mohan4220/ecu/docs/circuits/README.md

# ECU-25 Reference Circuits

Generated by `hardware/reference-circuits/generate.py` (schemdraw). These are the
design references — component values calculated below — and the source of truth
until the KiCad schematics are captured. Each SVG/PNG pair shows one channel;
multiply by channel count for the full board.

For the channel-by-channel signal list — every quantity measured, its terminal,
scaling and MCU pin, and every output driven — see
[docs/io-map.md](../io-map.md).

| # | Circuit | Channels on board |
|---|---|---|
| 00a | System context block diagram | — |
| 00b | Main-board subsystem block diagram | — |
| 01 | Power input protection | 1 |
| 02 | Buck 12 V → 5 V | 1 |
| 02b | COT ripple injection (Type-3) | 1 |
| 03 | LDO 5 V → 3.3 V | 1 |
| 04 | Digital input | 8 |
| 05 | Resistive sender input | 3 |
| 06 | MPU / RPM input | 1 |
| 07 | AC voltage sense | 6 |
| 08 | CT input | 3 |
| 09 | Relay driver | 6 |
| 10 | CAN transceiver | 1 |
| 11 | RS485 transceiver | 1 |
| 12 | MCU core (crystals, reset, boot, SWD, RTC backup) | 1 |
| 13 | VREF_MID 1.65 V buffer | 1 (feeds 9 ch) |
| 14 | Switched 12 V rail (+12V_SW) | 1 |
| 15 | Battery voltage sense | 1 |
| 16 | Charge alternator D+ excite/sense | 1 |
| 17 | EEPROM SPI wiring | 1 |
| 18 | Display board — 4.3" TFT + RA8875 (block level) | 1 board |

Ordering: [../bom/ecu25-main-bom.md](../bom/ecu25-main-bom.md) (generated from
the schematic). Bench work: [../bom/breadboard-prototype.md](../bom/breadboard-prototype.md)
— through-hole substitutes per subsystem, with a build order and the safety
rules for the AC-sensing and CT blocks.

## Design calculations

### 01 — Input protection
- **System: 12 V, ~75 Ah battery** (Kirloskar KG4-25WS1 / engine 3R550ETA 4G1, CPCB IV+ — the whole 25-58.5 kVA range is 12 V). Board spec 8-16 V.
- F1 **3 A**: real board draw is ≈0.45 A (buck ~0.13 A, coils 0.20 A, D+ 0.10 A, DIN wetting 13 mA, or up to 96 mA if all eight channels are jumpered ground-side with contacts closed). A 5 A blade is 11× the load and could not clear a 1 A internal fault; 3 A tightens coverage while still clearing the C9 inrush (I²t ≈ 0.8 A²s against a ~3.5 A²s melt).
- D1 SMCJ16CA: 16 V standoff (above the 15 V charging max), clamps ≈26 V; buck is 100 V rated → large margin.
- **Jump-starting from a 24 V source will destroy this board, by design.** ISO 16750-2 specifies a 24 V / 60 s jump-start test for 12 V systems; with a 16 V-standoff TVS we clamp, blow F1, and D1 most likely fails short — the safe direction, but a sacrificial one. This is the price of clamping at 26 V instead of 53 V, which is what protects the LM358s (32 V absolute max) sitting on the raw rail. If 24 V jump-start survival is ever required the answer is a series-pass overvoltage cutoff, not a bigger TVS. **The installation manual must say: do not jump-start from 24 V.**
- Q1 P-FET −60 V: survives clamped load dump. R1 100k gate pull-down; D2 12 V zener holds V_GS within the FET rating.
- C1 100 µF 35 V + C2 100 nF sit on the battery side of D3 and handle ripple, not ride-through.
- **Crank ride-through (D3 + C9).** A 12 V system dips far lower under crank than a 24 V one, so the logic gets its own diode-isolated reservoir: D3 (SS34) blocks, C9 2200 µF holds. With the backlight shed, the logic draws ≈1 W at the buck input; from 10 V down to the 6.5 V UVLO that is ½·C·(10²−6.5²) = 0.05 J ≈ 1.7 mF minimum, so 2200 µF carries ≈63 ms — against the DSE-class figure of surviving 0 V for 50 ms from ≥10 V. **That 1 W is a ceiling, not a margin**: it assumes the backlight is shed, and at 1.5 W the hold-up falls to ~42 ms and the claim fails. Two consequences to close on the first board: measure the real load and re-derive, and *implement* the backlight shed (battery sense taps +12V ahead of D3, so the sag is visible within one 10 ms tick) — today it is an assumption, not code. Inrush into C9 is ~58 A for ~0.5 ms, which the SS34 (100 A I_FSM) and the fuse both survive, but it pits screw terminals on repeated hot-plugging. The coils tap +12V *ahead* of D3 and simply latch through the sag; a G5LE releases far below 12 V.
- **The UVLO divider senses the hold-up node, not the battery.** Sensing the battery would trip EN the instant the harness sagged and shut the buck off while C9 still held charge — defeating the whole reservoir.

### 02 — Buck (LM5164-Q1)
- FB ref 1.2 V: R5/R6 = 38.3k/12.1k → V_OUT = 1.2 × (1 + 38.3/12.1) = 5.00 V.
- UVLO: EN threshold 1.5 V rising / 1.4 V falling, R2/R3 = 100k/30.1k → turn-on **6.48 V**, turn-off **6.05 V** (0.43 V hysteresis). Turn-off sits essentially on the LM5164's own 6 V minimum input, which is deliberate — the datasheet supports operation down to 6 V at near-100 % duty — but it means a battery parked between 6.05 and 6.48 V during a very long crank will chatter.
- RON = **41.2k** → fsw = V_OUT × 2500 / R_RON = 5 × 2500 / 41.2 ≈ **303 kHz**. The formula has **no V_IN term**: the LM5164 varies on-time inversely with V_IN precisely so frequency stays constant, so an earlier claim here that frequency scaled with input volts was wrong — and the old 100k was never 300 kHz at *any* input, it was 125 kHz. ΔI = 5 × 0.583 / (303 kHz × 33 µH) ≈ 0.29 A (29 %), rising to ≈0.33 A at 14.4 V — well inside the LM5164's 1.5 A peak limit.
- **Type-3 ripple injection (R7 100k, C10 4.7 nF, C11 1 nF C0G).** COT has no error amplifier: the on-time restarts when FB falls to the 1.2 V reference, so the datasheet requires ≥20 mV of FB ripple *in phase* with the inductor current. Our all-ceramic output produces ΔI/(8·f·C) = **2.7 mV**, and that component is capacitive — out of phase — so the required series resistance would be R_ESR ≥ V_OUT×20 mV/(V_FB×ΔI) = **0.287 Ω** against the ~2 mΩ two 22 µF MLCCs actually have, i.e. two orders of magnitude short. Left alone the part burst-switches (multiple on-times then a long off-time). Type-3 avoids adding output ESR: R7/C10 across SW and V_OUT rebuild the triangular ramp, C11 couples it into FB. C10 ≥ 10/(f_SW·(R5∥R6)) = 10/(303 k × 9.20 k) = 3.6 nF → 4.7 nF; R7 ≤ t_ON·(V_IN−V_OUT)/(20 mV·C10) = 1.31 µs × 7.6 / (20 m × 4.7 n) = 106 k → **100 k**, giving 21 mV at 12.6 V and 13 mV at 8 V (datasheet floor 12 mV). At the 6.5 V UVLO edge it falls to ~8 mV — below spec, but that is a sub-second crank transient, not an operating point. C11 ≥ t_settle/(3·R5) = 75 µs/115 k = 0.65 nF → **1 nF, C0G** (a Y5V here would lose most of its value under bias). Cost of the network: the injected ramp shows up as a DC error of about half its amplitude, ~10 mV at FB, ~44 mV at the output.

### 03 — LDO (TLV75533)
- Fixed 3.3 V, 500 mA (reviewer: TPS7A4901's 150 mA was marginal — MCU ~100 mA + RS485 ~25 mA + display logic ~40 mA + peaks).
- LCD backlight runs from the 5 V rail over the ribbon, not from the LDO.

### 04 — Digital input
- Divider **5.6k/1.8k** from 12 V → 2.92 V at node, wetting current ≈ 1.6 mA. The old 10k/3.3k gave 5.95 V and 1.8 mA at 24 V but only **0.9 mA** at 12 V — below what reliably breaks through oxide on a dirty panel contact.
- R12 + BAT54S clamps node to rails; clamp current ≈ 0.24 mA worst case.
- τ = (5.6k∥1.8k) × 1 µF ≈ 1.4 ms; firmware debounce ×3 samples on top.
- Ground-switched contacts: R231-238 (**1k** to +12V, via JP4-11) pull the input high so a contact to GND reads as active. Fit either the pull-up or the field 12 V feed, never both. The value is set by the *worst* case, not the nominal one: the open-contact node is V_bat × 1.8/(R+7.4), and against V_IH 1.785 V that needs R ≤ 670 Ω at 8.0 V — 2.2k gives 2.25 V at 12.6 V but only **1.59 V at the 8.5 V crank sag**, back inside the indeterminate band (SME catch). 1k gives 2.57 V at 12.6 V and 1.82 V at 8.5 V. Cost: 12 mA per channel while the contact is closed, against 5.5 mA at 2.2k.

### 05 — Sender input
- Current source (LM358 + BC857 + R_set, drawn as I1): 0.5 V ref across 62 Ω → 8.06 mA (oil, fuel); 249 Ω → 2.0 mA (temp, avoids saturation on cold NTC).
- Implementation (KiCad): high-side source from +5 V; the 0.5 V drop is set by a 4.5 V reference (10k/90.9k + 100 nF from +5 V) on the op-amp +input, feedback from the BC857 emitter. LM358 runs from +12 V so its input common-mode range (V+ − 1.5 V) clears the 4.5 V reference easily.
- Oil 184 Ω × 8 mA = 1.48 V full scale; 12-bit ADC → ≈0.1 Ω resolution.
- R23/C20 filter; R26 4.7k + BAV199 clamp holds the fault current into the MCU pin to ≈3.6 mA when a sender shorts to +12 V.

### 06 — MPU / RPM
- C30 AC-couples; R31/R32 bias +input to 1.65 V; R33/R34 set −input threshold 1.65 V.
- R36 1M positive feedback: hysteresis ≈ 3.3 V × (50k / 1.05M) ≈ ±80 mV.
- BAV99 + R30 clamp ±50 V pickup swings.

### 07 — AC voltage sense
- 4 × 330k + 5.62k: ratio 1/235.9 → 340 Vpk → 1.44 Vpk about the 1.65 V bias (ADC sees 0.22–3.08 V). Clips at ≈276 V RMS — above the 110 % over-voltage trip point (264 V), so protection still reads real numbers at trip.
- Fault current if output shorted: 340 V / 1.32 MΩ ≈ 0.26 mA — inherently safe.
- 4 series 1206 → ≈85 Vpk per resistor (200 V rated) + creepage across the chain.
- R45/C40: effective fc ≈ 1.1 kHz (source ≈ 5.62k∥1.32M + 1k with 22 nF), −2.6° at 50 Hz. CT channel: R53 6.8k + 22 nF → fc ≈ 1.06 kHz — matched within ≈0.1°, so the phase error cancels in power/PF.
- Terminals (KiCad, J5/J6): 8-pole 5.08 mm blocks with only the **odd poles wired** → 10.16 mm live-to-live pitch. 415 V L-L rides between adjacent phases (and up to ~680 Vpk GEN-phase to MAINS-phase between unsynchronized sources); a fully-populated 400 V-class 5.08 mm block doesn't meet PD2 creepage for that (PCB review catch). On-board: 3.0 mm clearance class + copper-pour keepout under the terminals and divider chains.

### 08 — CT input
- Burden 0.05 Ω: 5 A RMS → 0.25 V RMS, dissipation 1.25 W on a 3 W part (42 % derating).
- MCP6002 ×2 → ±0.71 Vpk about 1.65 V at rated current; output clips at ≈11.7 A RMS (2.3×In) — ample for time-graded overcurrent curves. The gain pairs (R51/R52 etc.) are **1 %**: two 5 % parts would give up to 7 % gain error on every current and power reading.
- D50 bidirectional TVS across the CT terminals — protects the pluggable connector if a live CT is opened.
- R53 6.8k phase-matches the voltage-channel filter (see 07).

### 09 — Relay driver
- 2N7002K (60 V): **G5LE-1-DC12** coil is 360 Ω / 400 mW → **33.3 mA**; six coils ≈ 200 mA. 60 V clears the 26 V clamp with a wide margin. R61 keeps the FET off during MCU reset.
- SS34 flyback clamps coil kickback to ~0.4 V above +12V_SW.
- **Contacts are dry and pilot-duty.** J8 is a 6-pole body, all six wired: pins **1 and 6 are both OUT_COM**, the common contact supply, which the *installer* feeds from a fused source — it is not this board's rail, so no field current crosses the PCB. Two poles rather than one so the installer can land a supply and a jumper without doubling wires into one terminal. Pins 2-5 are the NO contacts: FUEL (ECU enable), START, AUX1, AUX2.
- **OUT_COM rating: 4 A total, 2 A per output, installer fuse 4 A.** The relay contacts are 8 A each, but the *board* is the limit: OUT_COM runs in the Battery class (2.0 mm ≈ 4-5 A at a 10-20 °C rise, IPC-2221 external 1 oz) and each output in the Power class (1.0 mm ≈ 2.4 A). Four contacts at their 8 A rating would be 32 A on a trunk sized for 4 — so the ceiling has to be stated, and it belongs on the installer's drawing (SME catch: it was implied by the netclass and written down nowhere). **START is pilot only**: a 12 V starter solenoid pulls 20-40 A and glow plugs 28-60 A against 8 A DC contacts, so it must drive an external starter relay coil.
- +12V_SW therefore feeds only the six coils (200 mA) and the D+ excitation (100 mA).
- K5/K6 are **configurable** (AUX1/AUX2, defaulting to horn and preheat): on a CRDi engine the ECU owns the cold-start aid, so a hard-wired preheat channel would often sit idle.
- GEN and MAINS contactor channels are **volt-free pairs** (COM+NO) on their own block **J15** — GEN and MAINS contactor channels are **volt-free pairs** (COM+NO) on their own block **J15** — contactor coils run on their own AC source, and the panel hardware interlock stays load-bearing. J15 is an 8-pole 5.08 mm body with only the **odd poles wired** (10.16 mm live pitch): the two contactor circuits ride different AC sources (up to ~650 Vpk between them), which a fully-populated 5.08 mm block can't hold creepage for (PCB review catch — same reason J8's old poles 5–8 moved off it).
- G5LE-1 pin map (lib symbol/footprint): coil = pins 2/5, COM = 1, NO = 3, NC = 4 unused (PCB review catch — an earlier assumption of 1/2 = coil netted every relay wrong).
- K1 run-enable energizes from PREHEAT onward (not just crank): gives a J1939 engine ECU its boot time before the starter engages; in legacy mode it merely energizes the fuel solenoid early.

### 10/11 — Comms
- CAN split termination 2 × 60 Ω + 4.7 nF (fit JP1 only at bus ends) — better common-mode filtering than single 120 Ω.
- RS485: 120 Ω term (JP2, ends only). THVD1450 has a true fail-safe receiver; the 560 Ω bias is belt-and-braces (with both terminations fitted it only reaches ≈170 mV — the internal fail-safe is what guarantees idle state).

### 12 — MCU core
- **VCAP1/2: 2 × 2.2 µF** for the F407's internal 1.2 V core regulator — mandatory, the MCU does not boot without them. VREF+ ties to the filtered VDDA.
- HSE 8 MHz, load caps 12 pF (C = 2(CL−Cstray) with CL = 10 pF, stray ≈ 4 pF); LSE 32.768 kHz, 6.8 pF (CL ≈ 6 pF low-drive).
- VBAT: BAT54 + 330 Ω charges the 0.22 F supercap gently — without the resistor the 3.3 V LDO sits in current limit for seconds at every cold start. RTC draw ~1 µA → ≈60 h backup.
- VDDA fed through ferrite + 1 µF/10 nF — keeps digital switching noise off the ADC reference.
- BOOT0 10 k pulldown = boot from flash; JP3 to 3V3 invokes ROM UART bootloader (recovery without debugger).
- SWD (KiCad): TC2030 tag-connect footprint, J11 — 6 pads, no fitted connector cost; NRST also on it.

### 13 — VREF_MID buffer
- 10k/10k from 3.3 V → 1.65 V, decoupled at the divider node by C90 100 nF; MCP6002 buffer isolates the divider from 9 channel loads. 47 Ω isolation + 10 µF, dual feedback (final values, in KiCad): R93 10k takes DC feedback from after the 47 Ω, C93 100 nF closes the loop at AC directly from the op-amp output — the R92·C91 pole sits outside the fast loop, so low output impedance at 50 Hz without oscillation and no bias crosstalk between channels.

### 14 — +12V_SW
- PTC 1.1 A hold: 6 coils × 33.3 mA = 200 mA + D+ 100 mA ≈ 300 mA. Field loads are no longer on this rail (they come from J8 pin 1), so the budget covers only the coils and D+. PTC trips on a stuck/shorted coil without killing the logic supply. **RXEF110, radial, 72 V** — while tripped it stands off the ~53 V load-dump clamp, and no *chip* PPTC does that at 1.1 A hold: the 1206 0ZCJ0110 is 8 V and the 1812 parts are 33 V (BOM review catch — an earlier revision of this sheet claimed a 60 V 1812 part that does not exist). Local SMBJ33**CA** (bidirectional, matching the two-anode TVS symbol) clamps coil-switching transients — the unidirectional SMBJ33A would risk a footprint-time cathode-to-GND forward short (schematic review catch).

### 15 — Battery sense
- 100k/22k = ÷5.55 → 16 V reads 2.88 V, using most of the ADC span on a 12 V system. 12-bit LSB ≈ 4.5 mV of battery. (÷15.7 was sized for 24 V and would have used under a third of the range here.)

### 16 — Charge alternator D+
- 120 Ω 3 W from +12V_SW ≈ 100 mA excitation (replaces the charge-lamp current that self-excites the alternator). 3 W part: 1.2 W dissipates continuously during a charge-fail — exactly the fault it must survive. 220 Ω would give only 55 mA at 12 V, which may not self-excite.
- 100 nF at the ADC node, matching the battery-sense channel.
- Same ÷5.55 divider; engine running + D+ < ~half battery ⇒ charge-fail warning.

### 17 — EEPROM
- All SPI2; CS pulled up so the chip stays deselected during MCU reset; WP/HOLD tied high via 10 k (software write protection only).

### 18 — Display board
- 4.3" 480×272 color TFT via RA8875 graphics controller (own framebuffer + drawing hardware) → MCU stays on SPI, no parallel RGB bus, no MCU upgrade.
- Single SPI bus shared by RA8875, 74HC595 (LEDs), 74HC165 (keys) with separate selects → 20-way ribbon carries everything including power (3V3 logic, 5 V backlight ~250 mA, PWM dimming).
- UI firmware: LVGL, developed against its PC simulator first.

## Review status

Independently design-reviewed 2026-08-11 (all calculations re-derived, all diagrams inspected). Fixes applied: TVS polarity (14), VCAP caps (12), GND-side switch pull-up (04), comparator supply (06), V/I filter phase matching (07/08), CT burden/headroom/TVS (08), 60 V relay FET (09), supercap inrush resistor (12), 500 mA LDO (03), VREF buffer feedback (13). Notes: BAV199 symbols show one diode of the dual pair (second half to GND implied); D1 (SMCJ33CA at the time of that review, SMCJ16CA since the 12 V conversion) is bidirectional despite the unidirectional symbol; refdes get final rationalization in KiCad.

KiCad capture independently SME-reviewed 2026-08-16 (netlist re-derived against this sheet, probes run): 3 criticals + 6 majors found and fixed — buck RON short, comparator input merge, supercap diode reversed, UVLO divider defeated, RS485 bias polarity, floating spare op-amp, LED reversed, VREF dual feedback captured (R93/C93), D80 → SMBJ33CA. Re-verified against a fresh netlist: ship. The schematic (`hardware/kicad/ecu25-main/`) carries the final refdes; this sheet keeps the design math.

J1939 firmware module reviewed the same way (probe programs, J1939-71/-73/-81 conformance) — see firmware commit history for the fix list.

BOM and breadboard-prototype guide independently SME-reviewed 2026-08-25 (netlist reconciliation, datasheet checks on every part number, arithmetic re-derived). Reached back into the design: **F2 was specified as a 60 V 1812 PPTC that does not exist** (the 0ZCJ0110 is 8 V / 1206) → RXEF110 radial 72 V; C1/C2 raised to 63 V / 100 V for the same load-dump clamp; CT gain pairs and the phase-match resistors now carry explicit 1 %. Board-side: netclass clearances retuned (the LQFP-100's own pads are 0.2 mm apart, so logic rails cannot take a wide clearance class) and the GND pour now fills at the widest non-HV class. The prototype guide itself gained the G5LE-1 pin map, the R18/R26 fault-limiting resistors, split comparator supplies, a corrected relay-driver transistor, CT burden wiring rules and the grounding rules for the low-voltage AC stand-in.

A verification pass on those fixes caught three more, all now corrected: the replacement PPTC footprint was too small for an RXEF110 (0.6 mm drill against 0.81 mm leads) → `Fuse_Bourns_MF-RG900`; the BC337-40 recommended for the breadboard relay driver is **E-B-C**, the opposite of the BC557B in the sender block, and was undocumented; and the **G5LE-1 coil current was wrong by 4× in three documents** — the DC24 coil is 1.44 kΩ / 400 mW / 16.7 mA, not 360 Ω / 67 mA. Nothing downstream breaks, because every sizing decision (FET rating, PTC hold, track width, base drive) was made against the larger number and therefore keeps margin. Board-side, the GND pour now has keepouts around every NPTH barrel and the minimum through-drill is 0.2 mm to match U1's library thermal vias — with those, the generated board reports **zero DRC errors** (only the unrouted ratsnest, silk-overlap warnings and headless library artifacts remain).

12 V conversion (2026-08-25): the target set was confirmed as a **Kirloskar KG4-25WS1**, engine **3R550ETA 4G1**, CPCB IV+ — a 3-cylinder 1.65 L CRDi with **EGR + DOC** and a **12 V / 75 Ah** electrical system. The board had been designed 24 V throughout. Everything voltage-dependent was rescaled (see the sections above); the output stage was restructured so no field current crosses the PCB; K5/K6 became configurable AUX channels. Two consequences worth recording: the "360 Ω" relay coil that an earlier revision of this sheet carried was in fact the **12 V** part all along (G5LE-1-DC12 is 360 Ω / 33.3 mA), so the "correction" to 1.44 kΩ made during the BOM review was itself wrong for this system; and because the aftertreatment is EGR + DOC rather than SCR, the controller needs **no DEF/AdBlue monitoring and no DPF regeneration management** — a DOC is passive.

Firmware SME review of the AC/sensor/runtime/STM32 work (2026-09-07). Two criticals, both of which needed two modules read together to see. **A routine Modbus poll could start the engine**: `plat_rs485_tx()` busy-waited 26.6 ms for a 51-byte reply, the main loop is the only thing draining the ADC ring, and the ring held 2.5 ms — so a SCADA master reading all 23 input registers at 10 Hz punched a hole in the AC sample stream every window. `ac_sense` indexes zero crossings by sample number, so a hole reads as time that did not pass: mains frequency pinned at 53.3 Hz, outside the AMF window, and after the 5 s qualification the controller declares a mains failure and transfers load. Fixed three ways — interrupt-driven TX, a 64-set (20 ms) ring, and an overrun flag that makes the runtime discard the corrupted window rather than publish a confident wrong number. Second critical: **a shorted coolant sender silently deleted the over-temperature shutdown**. On an NTC a short and a boiling engine are the same direction; the curve called the short "invalid", `protection.c` skips the analog branch when coolant is invalid, and coolant was not in `sensors_lost` — so no shutdown and no alarm. Which end of a sender curve is a *fault* is now stated per curve rather than inferred, and an invalid coolant reading raises SENSOR_LOSS. Majors: CAN had `ABOM` clear, so the unacknowledged address claim at power-up (the engine ECU is asleep with K1 open) drove the controller bus-off in ~16 ms, permanently; Modbus register 19 clamped reverse power to zero through `sat_u16`; a single write to the mode register locked the front-panel switch out for the whole power cycle and a remote start never expired; missed control ticks were dropped silently, so a slow loop would have made crank time, cooldown and every alarm delay run slow by the same ratio; and the CT ratio was hardcoded 50:5 in firmware against 200:5 on the schematic — a 4x current error that put the overcurrent trip at 4.6x the set's rating. The ratio now lives in one constant, `ECU25_CT_PRIMARY_A`, and the schematic text matches it. Minors fixed: `PWR->CR` written before the PWR clock was enabled, a silent fallback to the 16 MHz HSI on a dead crystal (now a deliberate hang), no input filter on the pickup capture, no `ENTRY()` in the linker script, and power counted from phases whose current was below the dead band, which pushed PF above 1. Sixteen new regression tests, each mutation-checked — the previous suite passed with the interpolation removed, the J1939 merge reverted, a DIN channel misassigned and the run-hour constant wrong by 10x.

Verification pass on the 12 V conversion (2026-09-06). Re-derived every fix against the TI, Omron, Nexperia and ST datasheets rather than trusting the commit; the hold-up energy math, the RON/UVLO arithmetic, the `modbus_rx` bounds, the AUX refactor and the dry-contact stage all held. Eleven majors did not, and are now fixed: the **COT ripple-injection network was missing entirely** — an all-ceramic output gives 2.7 mV of *capacitive* FB ripple against the 20 mV in-phase the LM5164 requires, so the part would have burst-switched (→ Type-3 R7/C10/C11, section 02); the **DIN ground-side pull-up at 2.2 k fell back into the indeterminate band at 1.59 V during an 8.5 V crank sag** (→ 1 k); the C9 25 V → 35 V change never reached the orderable BOM; the netclass assertion was **blind to the suffix patterns it was written to protect** and only fired after the board had already been written (→ result-based rules, checked before any file is saved); the hold-up node was still the autogenerated `Net-(D3-K)`, so the netclass keyed off a refdes (→ named `+12V_HLD`); the battery-threshold regression test passed with `batt_high_v` mutated back to the 24 V-era 30 V, and with `batt_low_v` at 13.5 V (→ phases at 12.0, 15.0 and 16.0 V, both mutations now caught); the explainer described an SMCJ33CA's 33 V standoff under the SMCJ16CA's name, directly contradicting the jump-start warning three files away; the battery-sense section still carried the ÷15.7 numbers (0–51 V, 12.6 mV/count) after the divider became ÷5.55; the circuit guide cited the generic 0.3/0.7·VDD logic thresholds four lines after citing the datasheet ones, which made its own fix look wrong; the OUT_COM **current ceiling was implied by the netclass and stated nowhere** (→ 4 A total, 2 A per output); and the reference diagrams still drew a 5 A fuse, a BZT52C15, an SQJ457EP and a buck with no D3/C9 at all. Sim-side, the plant's 0.1 V/s battery recovery kept the model below `batt_low` for 68 s across three crank attempts — a modelling artefact that would have masked real battery scenarios (→ 2 V/s below 11.5 V). Modbus now answers a too-small buffer with 0x04 SLAVE DEVICE FAILURE rather than 0x03, which had told the master to go looking for a bad field it never sent.

Footprint assignment + starting-point PCB independently SME-reviewed 2026-08-16 (pin-function mapping probes, ratings vs this sheet, IEC 60664-1 clearance/creepage): 1 critical — G5LE-1 relay pin map wrong (coil is 2/5, COM 1, NO 3; all six relays were netted dead with GEN/MAINS contacts tied to logic GND) — plus: GND had landed in the 415 V clearance class; 2.5 mm was insufficient for GEN-vs-MAINS (~680 Vpk); MKDS-3 fully-populated under-rated for 415 V L-L (→ 8-pole odd-wired J5/J6/J15, volt-free pairs split off J8 onto J15); volt-free nets unclassified; CT front-end and buck hot-loop parts packed far from their function; PTC 33 V under-rated (→ 60 V). All fixed and re-verified. Residual (accepted): 0.05 R shunt needs wide copper + Kelvin routing at layout time; DRU net names go stale if the project is re-annotated by hand (regenerate instead).

## Regenerating

```
.venv/bin/python hardware/reference-circuits/generate.py
```
