mohan4220/ecu/hardware/kicad/ecu25-main/ecu25-main.kicad_pcb

## KiCad design hardware/kicad/ecu25-main/ecu25-main.kicad_pcb (2026-09-07)

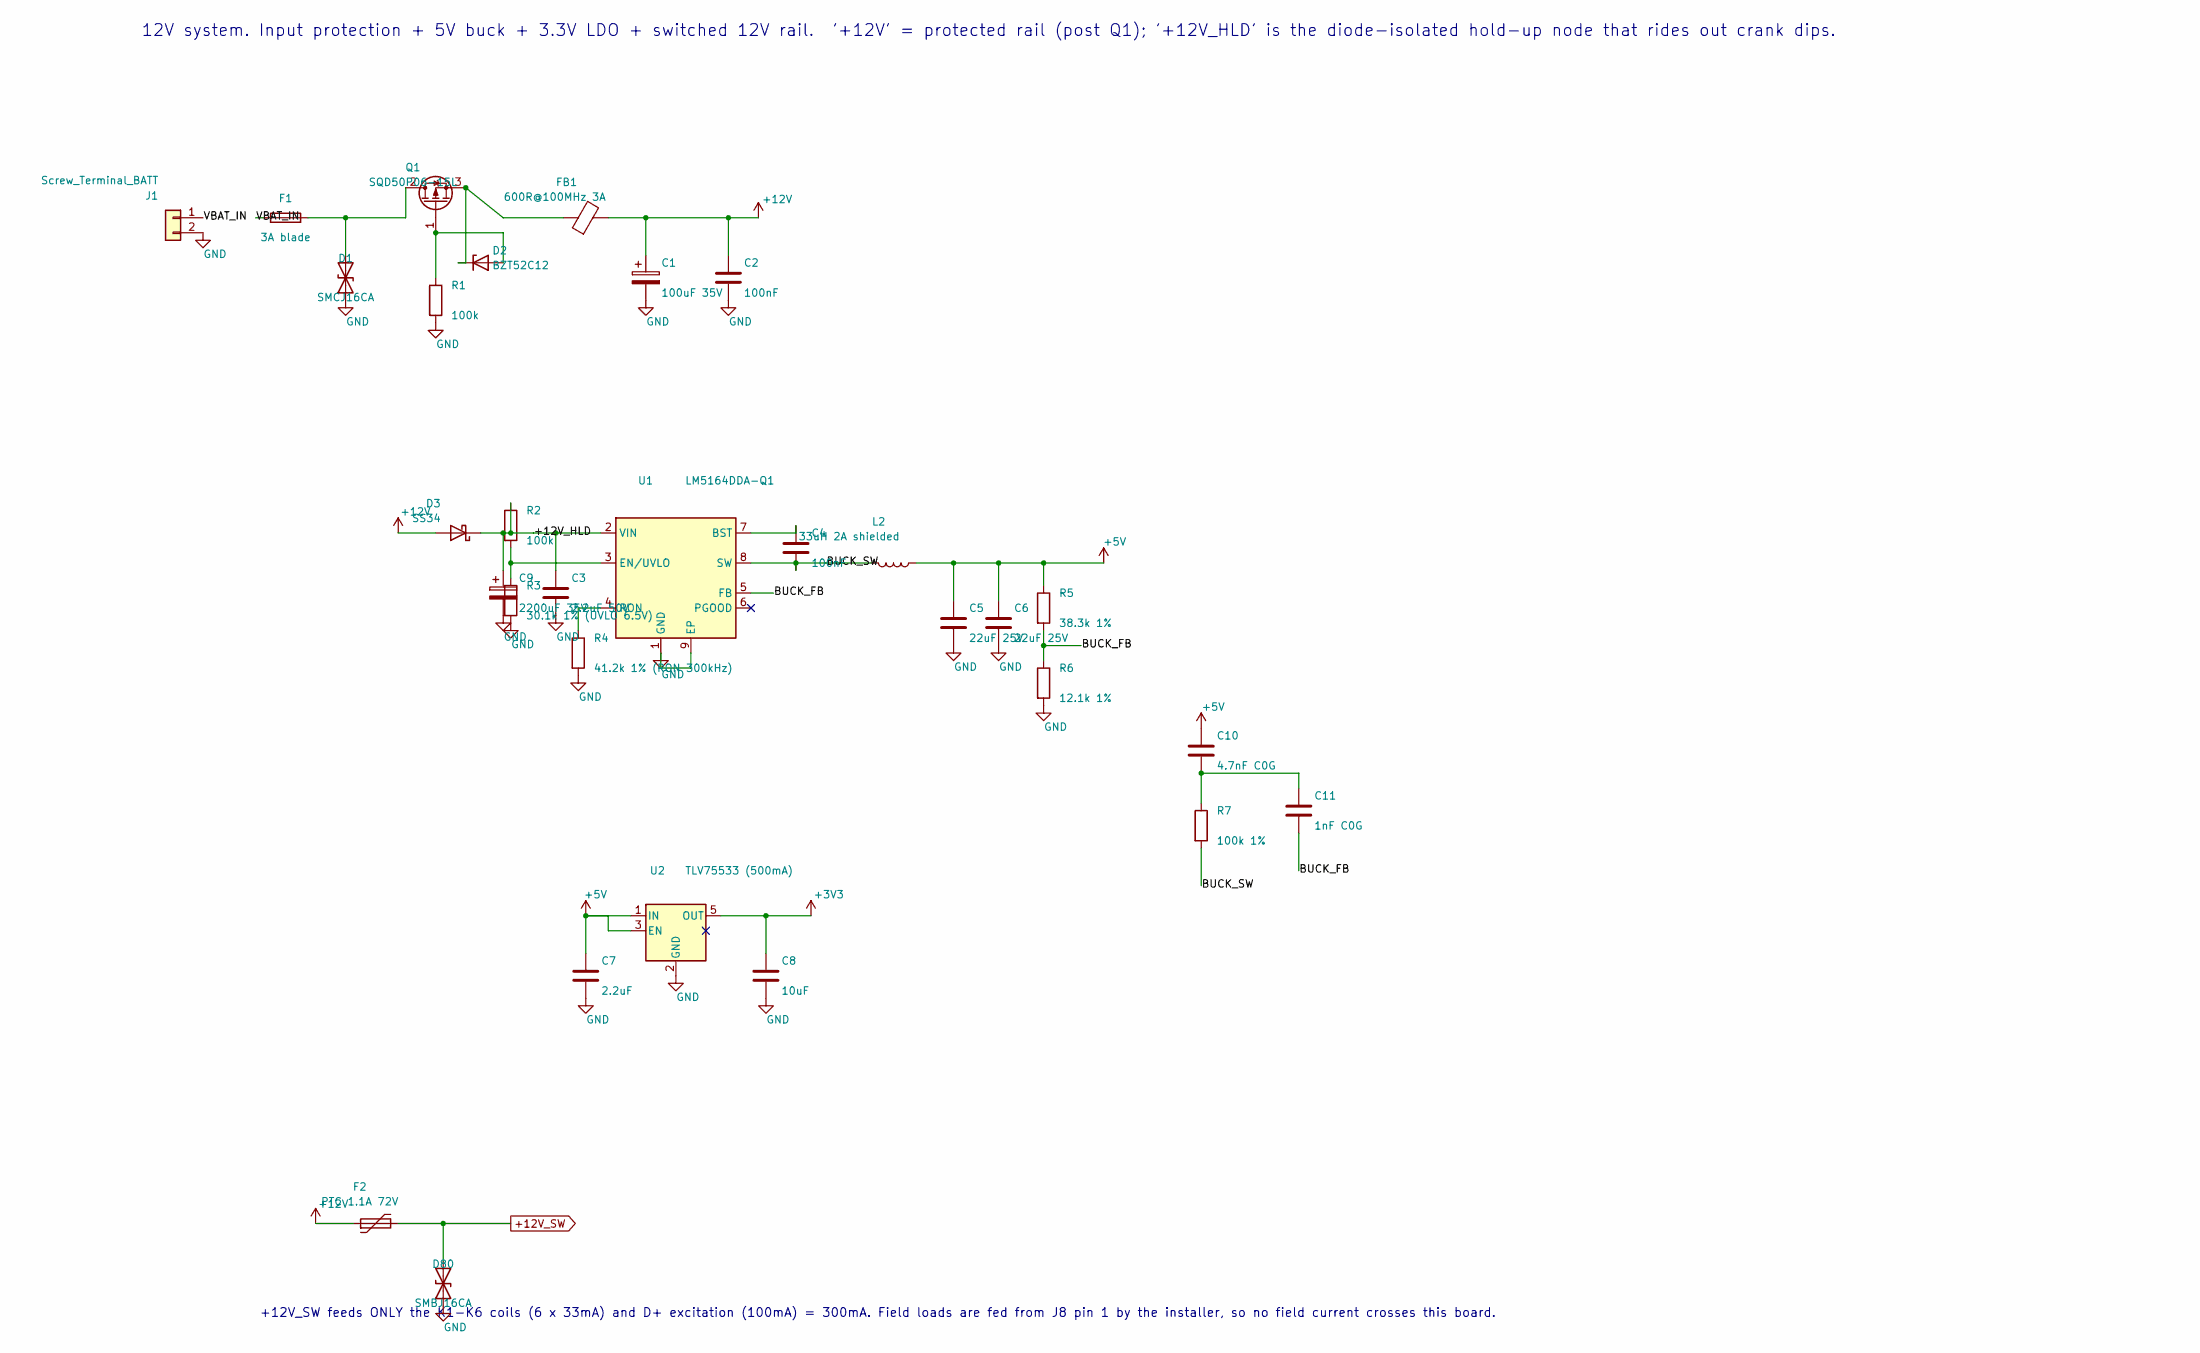
[picture p51: schematic power.kicad_sch]

Parts:
C1: 100uF 35V; CP_Radial_D8.0mm_P3.50mm
C2, C4: 100nF; C_0603_1608Metric
C3: 2.2uF 50V; C_1210_3225Metric
C5, C6: 22uF 25V; C_1210_3225Metric
C7: 2.2uF; C_0603_1608Metric
C8: 10uF; C_0805_2012Metric
C9: 2200uF 35V; CP_Radial_D12.5mm_P5.00mm
C10: 4.7nF C0G; C_0603_1608Metric
C11: 1nF C0G; C_0603_1608Metric
D1: SMCJ16CA; D_SMC
D2: BZT52C12; D_SOD-123
D3: SS34; D_SMA
D80: SMBJ16CA; D_SMB
F1: 3A blade; Fuseholder_Blade_Mini_Keystone_3568
F2: PTC 1.1A 72V; Fuse_Bourns_MF-RG900
FB1: 600R@100MHz 3A; L_0805_2012Metric
J1: Screw_Terminal_BATT; TerminalBlock_Phoenix_MKDS-3-2-5.08_1x02_P5.08mm_Horizontal
L2: 33uH 2A shielded; L_12x12mm_H8mm
Q1: SQD50P06-15L; TO-252-2
R1, R2: 100k; R_0603_1608Metric
R3: 30.1k 1% (UVLO 6.5V); R_0603_1608Metric
R4: 41.2k 1% (RON 300kHz); R_0603_1608Metric
R5: 38.3k 1%; R_0603_1608Metric
R6: 12.1k 1%; R_0603_1608Metric
R7: 100k 1%; R_0603_1608Metric
U1: LM5164DDA-Q1; SOIC-8-1EP_3.9x4.9mm_P1.27mm_EP2.514x3.2mm_ThermalVias
U2: TLV75533 (500mA); SOT-23-5

Connections:
+3V3: C8.1, U2.5 (OUT); also elsewhere on the board
+5V: C5.1, C6.1, C7.1, C10.1, L2.1, R5.1, U2.1 (IN), U2.3 (EN); also elsewhere on the board
+12V: C1.1, C2.1, D3.2 (A), F2.1, FB1.2; also elsewhere on the board
+12V_SW: D80.2 (A2), F2.2; also elsewhere on the board
/Power/+12V_HLD: C3.1, C9.1, D3.1 (K), R2.1, U1.2 (VIN)
/Power/BUCK_FB: C11.2, R5.2, R6.1, U1.5 (FB)
/Power/BUCK_SW: C4.2, L2.2, R7.2, U1.8 (SW)
/Power/VBAT_IN: F1.1, J1.1
GND: C1.2, C2.2, C3.2, C5.2, C6.2, C7.2, C8.2, C9.2, D1.1 (A1), D80.1 (A1), J1.2, R1.2, R3.2, R4.2, R6.2, U1.1 (GND), U1.9 (EP), U2.2 (GND); also elsewhere on the board
unnamed: C10.2, C11.1, R7.1
unnamed: D1.2 (A2), F1.2, Q1.2 (D)
unnamed: D2.2 (A), Q1.1 (G), R1.1
unnamed: D2.1 (K), FB1.1, Q1.3 (S)
unnamed: C4.1, U1.7 (BST)
unnamed: R2.2, R3.1, U1.3 (EN/UVLO)
unnamed: R4.1, U1.4 (RON)

Notes on the sheet:
12V system. Input protection + 5V buck + 3.3V LDO + switched 12V rail. '+12V' = protected rail (post Q1); '+12V_HLD' is the diode-isolated hold-up node that rides out crank dips.
+12V_SW feeds ONLY the K1-K6 coils (6 x 33mA) and D+ excitation (100mA) = 300mA. Field loads are fed from J8 pin 1 by the installer, so no field current crosses this board.

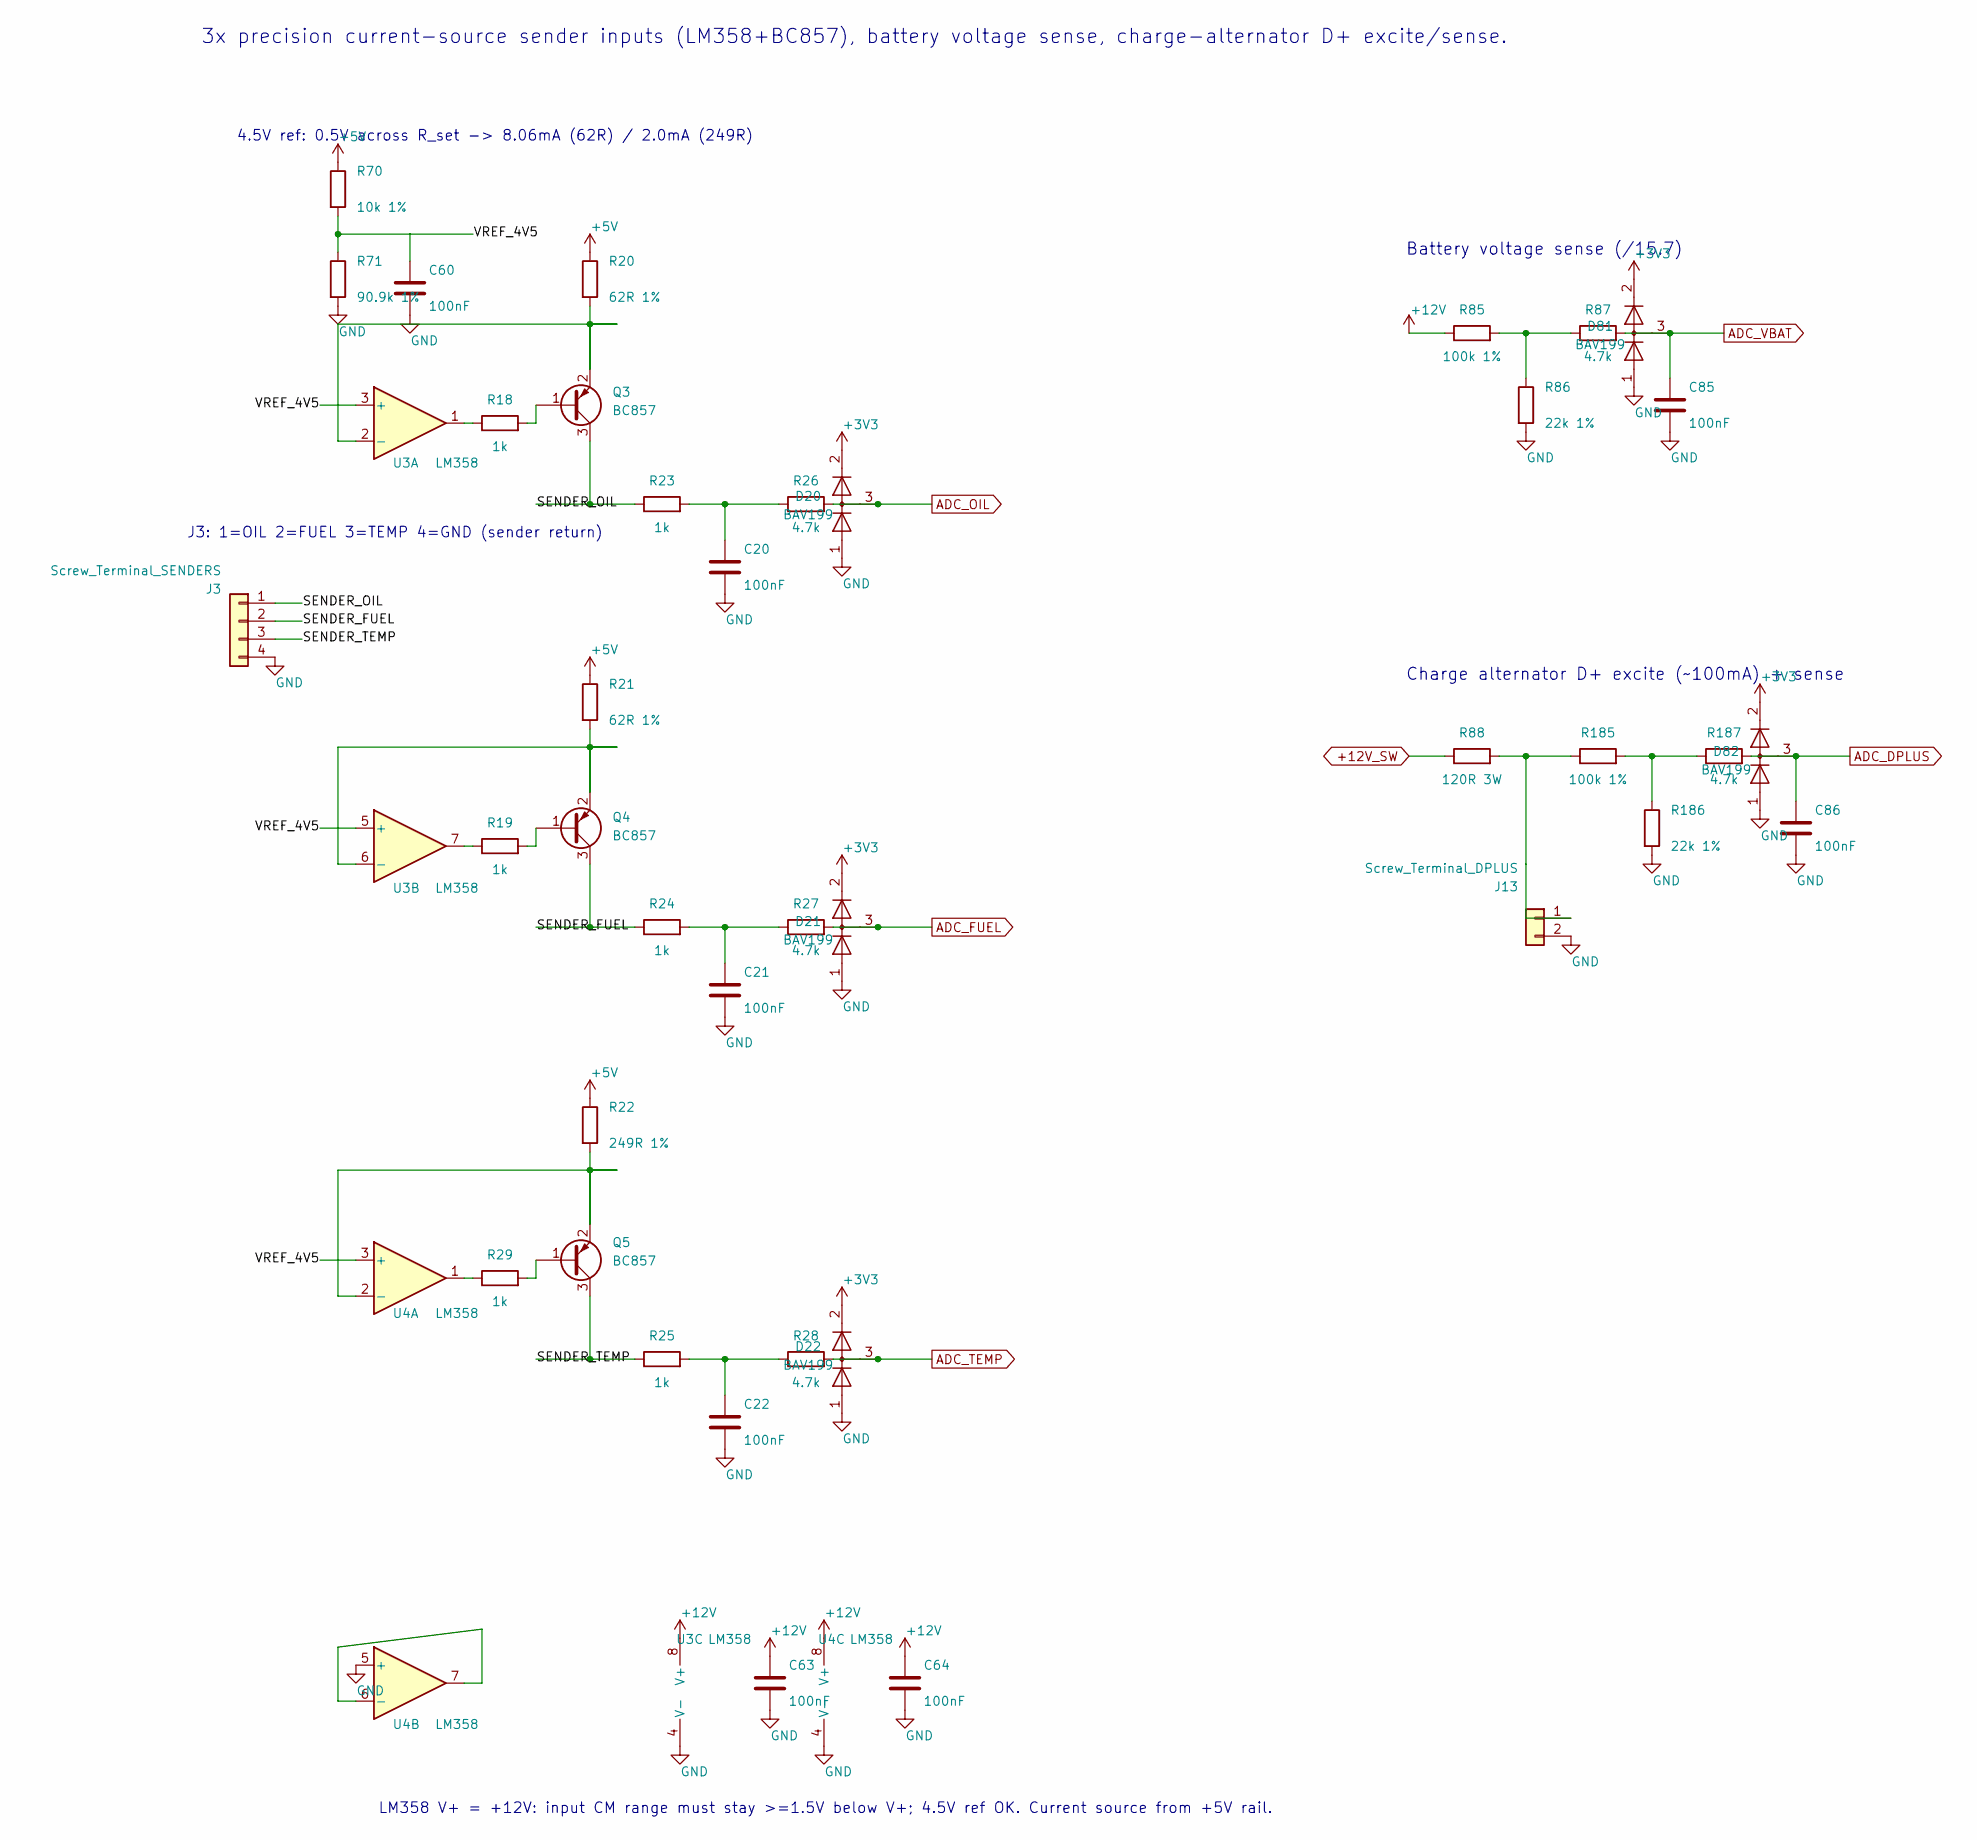
[picture p52: schematic analog.kicad_sch]

Parts:
C20, C21, C22, C60, C63, C64, C85, C86: 100nF; C_0603_1608Metric
D20, D21, D22, D81, D82: BAV199; SOT-23
J3: Screw_Terminal_SENDERS; TerminalBlock_Phoenix_MKDS-1,5-4-5.08_1x04_P5.08mm_Horizont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
J13: Screw_Terminal_DPLUS; TerminalBlock_Phoenix_MKDS-1,5-2-5.08_1x02_P5.08mm_Horizont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
Q3, Q4, Q5: BC857; SOT-23
R18, R19, R23, R24, R25, R29: 1k; R_0603_1608Metric
R20, R21: 62R 1%; R_0603_1608Metric
R22: 249R 1%; R_0603_1608Metric
R26, R27, R28, R87, R187: 4.7k; R_0603_1608Metric
R70: 10k 1%; R_0603_1608Metric
R71: 90.9k 1%; R_0603_1608Metric
R85, R185: 100k 1%; R_0603_1608Metric
R86, R186: 22k 1%; R_0603_1608Metric
R88: 120R 3W; R_Axial_Power_L20.0mm_W6.4mm_P25.40mm
U3, U4: LM358; SOIC-8_3.9x4.9mm_P1.27mm

Connections:
+3V3: D20.2 (A), D21.2 (A), D22.2 (A), D81.2 (A), D82.2 (A); also elsewhere on the board
+5V: R20.1, R21.1, R22.1, R70.1; also elsewhere on the board
+12V: C63.1, C64.1, R85.1, U3.8 (V+), U4.8 (V+); also elsewhere on the board
+12V_SW: R88.1; also elsewhere on the board
/Analog inputs/SENDER_FUEL: J3.2, Q4.3 (C), R24.1
/Analog inputs/SENDER_OIL: J3.1, Q3.3 (C), R23.1
/Analog inputs/SENDER_TEMP: J3.3, Q5.3 (C), R25.1
/Analog inputs/VREF_4V5: C60.1, R70.2, R71.1, U3.3 (+), U3.5 (+), U4.3 (+)
ADC_DPLUS: C86.1, D82.3 (K), R187.2; also elsewhere on the board
ADC_FUEL: D21.3 (K), R27.2; also elsewhere on the board
ADC_OIL: D20.3 (K), R26.2; also elsewhere on the board
ADC_TEMP: D22.3 (K), R28.2; also elsewhere on the board
ADC_VBAT: C85.1, D81.3 (K), R87.2; also elsewhere on the board
GND: C20.2, C21.2, C22.2, C60.2, C63.2, C64.2, C85.2, C86.2, D20.1 (K), D21.1 (K), D22.1 (K), D81.1 (K), D82.1 (K), J3.4, J13.2, R71.2, R86.2, R186.2, U3.4 (V-), U4.4 (V-), U4.5 (+); also elsewhere on the board
unnamed: C20.1, R23.2, R26.1
unnamed: C21.1, R24.2, R27.1
unnamed: C22.1, R25.2, R28.1
unnamed: J13.1, R88.2, R185.1
unnamed: Q3.1 (B), R18.2
unnamed: Q3.2 (E), R20.2, U3.2 (-)
unnamed: Q4.1 (B), R19.2
unnamed: Q4.2 (E), R21.2, U3.6 (-)
unnamed: Q5.1 (B), R29.2
unnamed: Q5.2 (E), R22.2, U4.2 (-)
unnamed: R18.1, U3.1
unnamed: R19.1, U3.7
unnamed: R29.1, U4.1
unnamed: R85.2, R86.1, R87.1
unnamed: R185.2, R186.1, R187.1
unnamed: U4.6 (-), U4.7

Notes on the sheet:
3x precision current-source sender inputs (LM358+BC857), battery voltage sense, charge-alternator D+ excite/sense.
4.5V ref: 0.5V across R_set -> 8.06mA (62R) / 2.0mA (249R)
J3: 1=OIL 2=FUEL 3=TEMP 4=GND (sender return)
LM358 V+ = +12V: input CM range must stay >=1.5V below V+; 4.5V ref OK. Current source from +5V rail.
Battery voltage sense (/15.7)
Charge alternator D+ excite (~100mA) + sense

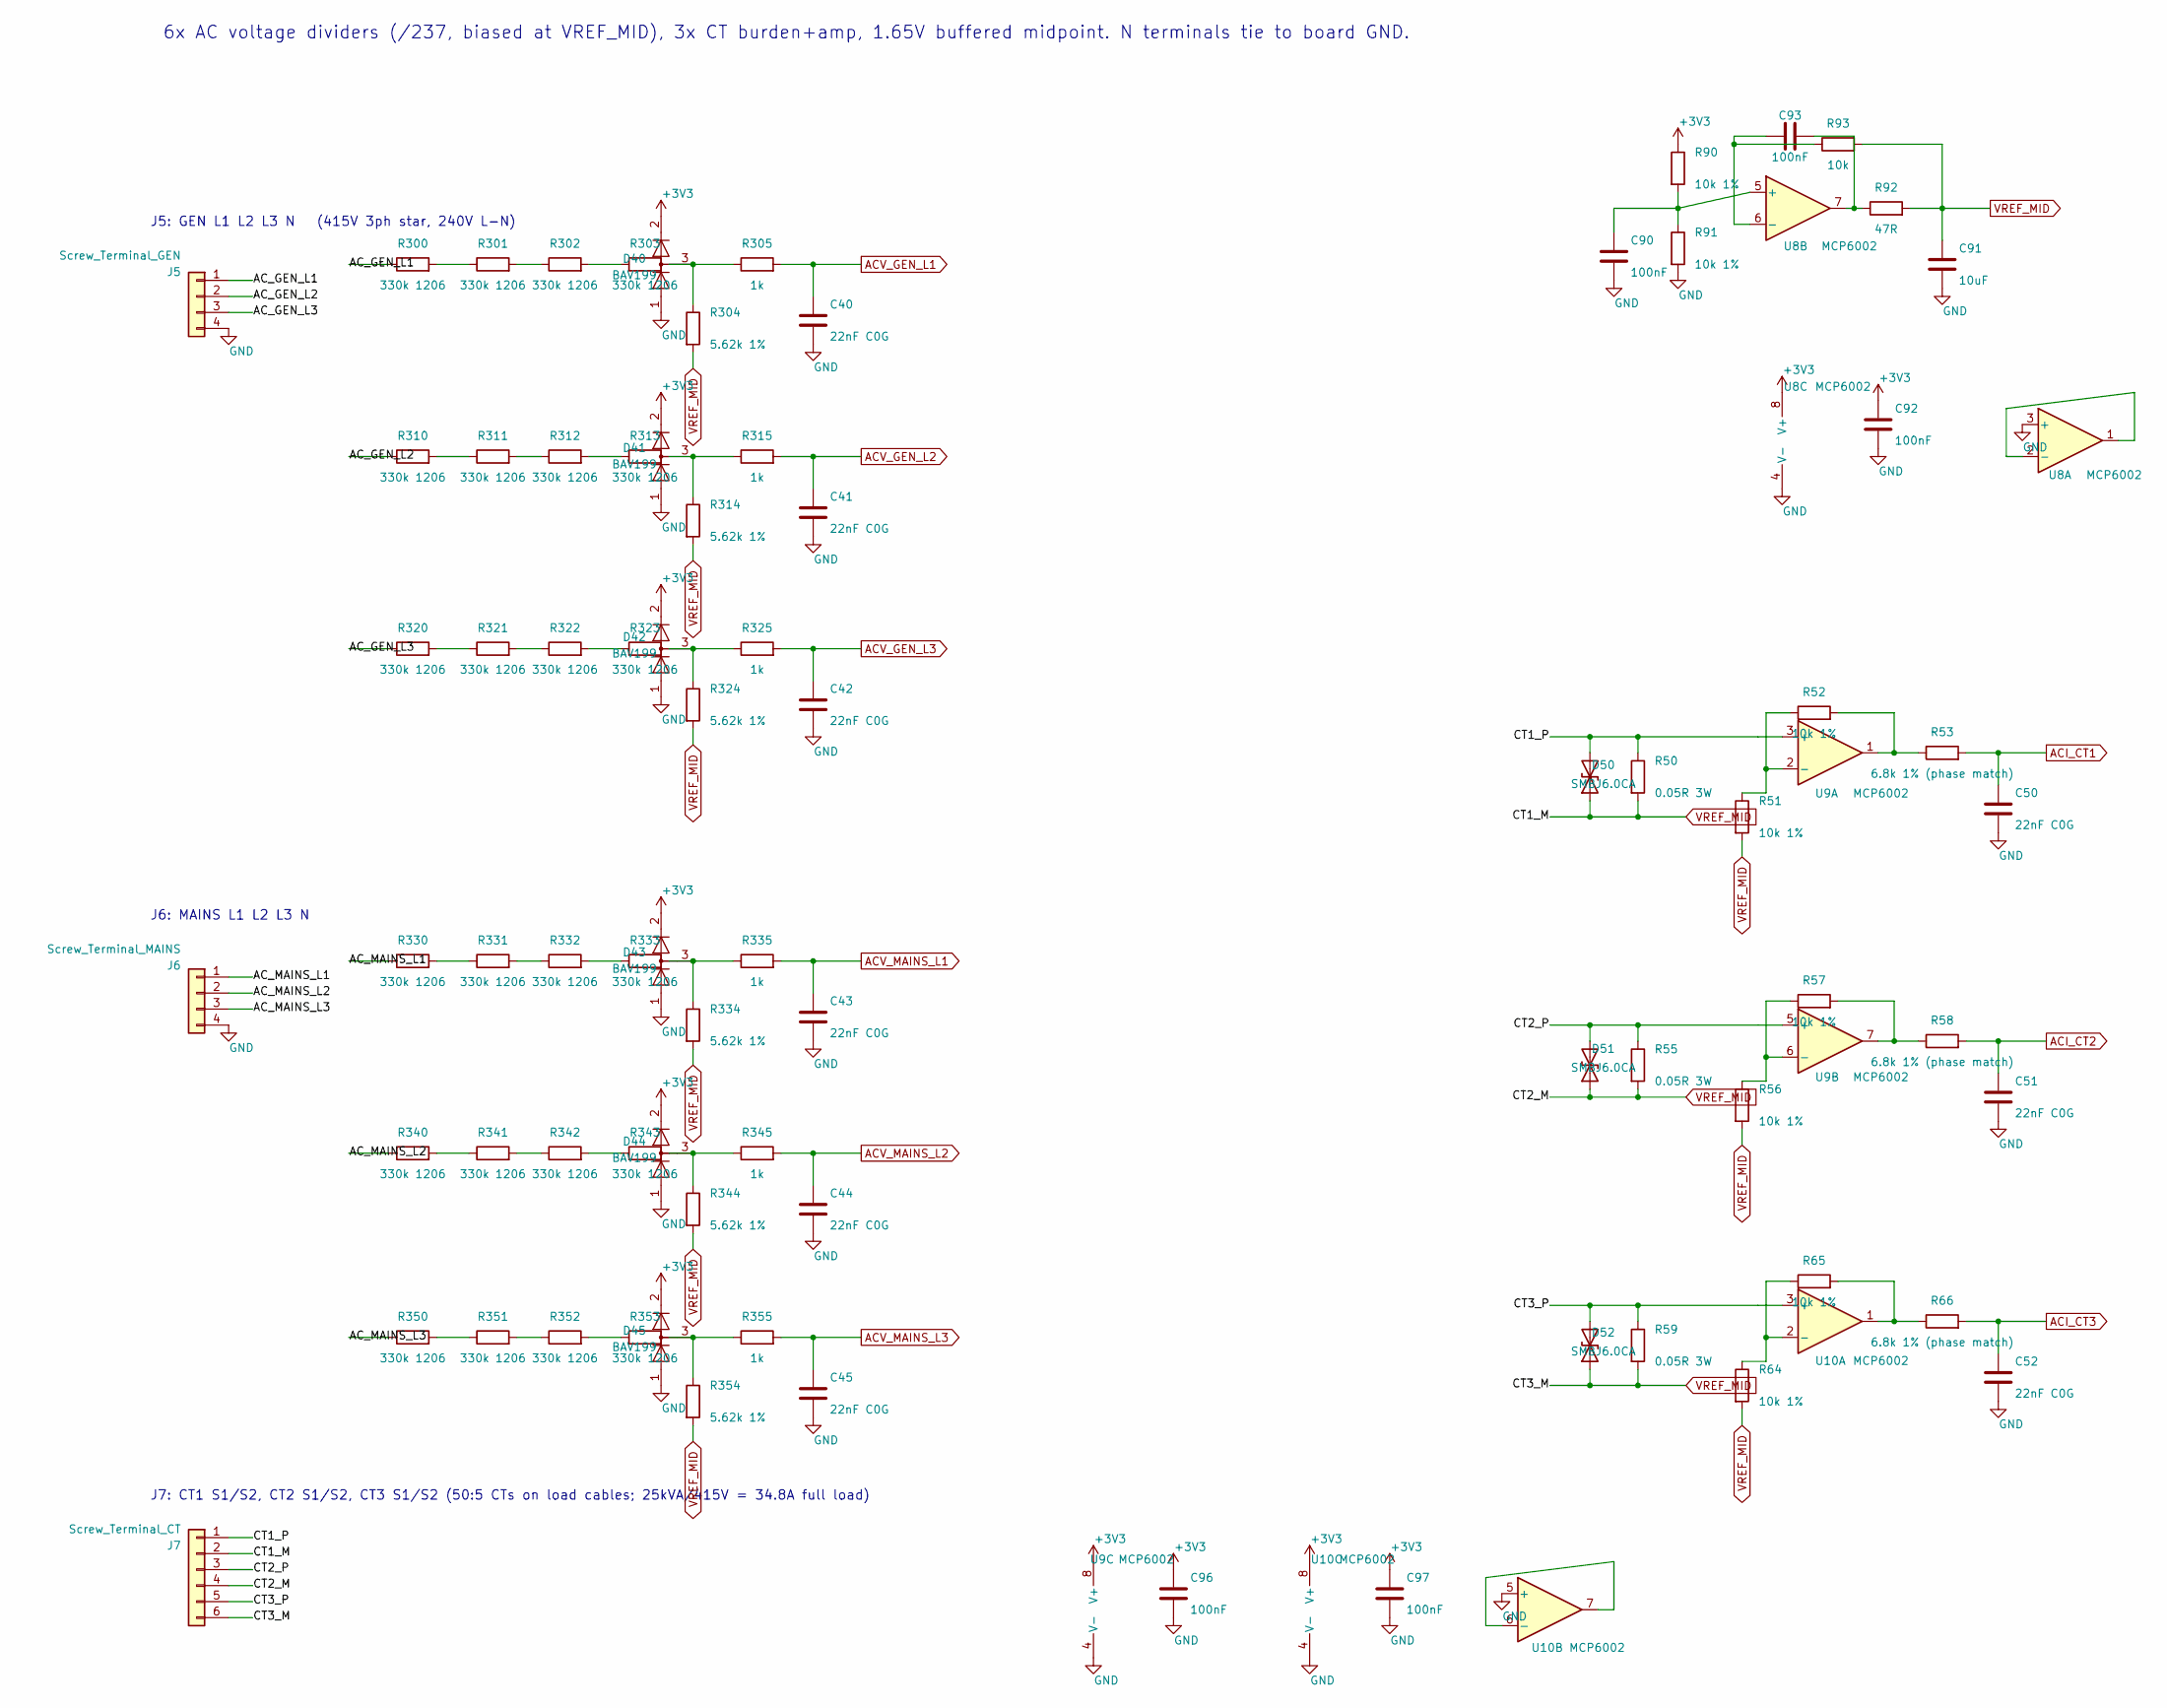
[picture p53: schematic ac_sense.kicad_sch]

Parts:
C40, C41, C42, C43, C44, C45, C50, C51, C52: 22nF C0G; C_0603_1608Metric
C90, C92, C93, C96, C97: 100nF; C_0603_1608Metric
C91: 10uF; C_0805_2012Metric
D40, D41, D42, D43, D44, D45: BAV199; SOT-23
D50, D51, D52: SMBJ6.0CA; D_SMB
J5: Screw_Terminal_GEN; TerminalBlock_Phoenix_MKDS-3-8-5.08_1x08_P5.08mm_Horizontal
J6: Screw_Terminal_MAINS; TerminalBlock_Phoenix_MKDS-3-8-5.08_1x08_P5.08mm_Horizontal
J7: Screw_Terminal_CT; TerminalBlock_Phoenix_MKDS-3-6-5.08_1x06_P5.08mm_Horizontal
R50, R55, R59: 0.05R 3W; R_2512_6332Metric
R51, R52, R56, R57, R64, R65, R90, R91: 10k 1%; R_0603_1608Metric
R53, R58, R66: 6.8k 1% (phase match); R_0603_1608Metric
R92: 47R; R_0603_1608Metric
R93: 10k; R_0603_1608Metric
R300, R301, R302, R303, R310, R311, R312, R313, R320, R321, R322, R323, R330, R331, R332, R333, R340, R341, R342, R343, R350, R351, R352, R353: 330k 1206; R_1206_3216Metric
R304, R314, R324, R334, R344, R354: 5.62k 1%; R_0603_1608Metric
R305, R315, R325, R335, R345, R355: 1k; R_0603_1608Metric
U8, U9, U10: MCP6002; SOIC-8_3.9x4.9mm_P1.27mm

Connections:
+3V3: C92.1, C96.1, C97.1, D40.2 (A), D41.2 (A), D42.2 (A), D43.2 (A), D44.2 (A), D45.2 (A), R90.1, U8.8 (V+), U9.8 (V+), U10.8 (V+); also elsewhere on the board
/AC sensing/AC_GEN_L1: J5.1, R300.1
/AC sensing/AC_MAINS_L1: J6.1, R330.1
/AC sensing/CT1_P: D50.2 (A2), J7.1, R50.1, U9.3 (+)
/AC sensing/CT2_P: D51.2 (A2), J7.3, R55.1, U9.5 (+)
/AC sensing/CT3_P: D52.2 (A2), J7.5, R59.1, U10.3 (+)
ACI_CT1: C50.1, R53.2; also elsewhere on the board
ACI_CT2: C51.1, R58.2; also elsewhere on the board
ACI_CT3: C52.1, R66.2; also elsewhere on the board
ACV_GEN_L1: C40.1, R305.2; also elsewhere on the board
ACV_GEN_L2: C41.1, R315.2; also elsewhere on the board
ACV_GEN_L3: C42.1, R325.2; also elsewhere on the board
ACV_MAINS_L1: C43.1, R335.2; also elsewhere on the board
ACV_MAINS_L2: C44.1, R345.2; also elsewhere on the board
ACV_MAINS_L3: C45.1, R355.2; also elsewhere on the board
GND: C40.2, C41.2, C42.2, C43.2, C44.2, C45.2, C50.2, C51.2, C52.2, C90.2, C91.2, C92.2, C96.2, C97.2, D40.1 (K), D41.1 (K), D42.1 (K), D43.1 (K), D44.1 (K), D45.1 (K), J5.4, J5.7, J6.4, J6.7, R91.2, U8.3 (+), U8.4 (V-), U9.4 (V-), U10.4 (V-), U10.5 (+); also elsewhere on the board
unnamed: C93.2, R92.1, U8.7
unnamed: D40.3 (K), R303.2, R304.1, R305.1
unnamed: D41.3 (K), R313.2, R314.1, R315.1
unnamed: D42.3 (K), R323.2, R324.1, R325.1
unnamed: D43.3 (K), R333.2, R334.1, R335.1
unnamed: D44.3 (K), R343.2, R344.1, R345.1
unnamed: D45.3 (K), R353.2, R354.1, R355.1
unnamed: R52.2, R53.1, U9.1
unnamed: R57.2, R58.1, U9.7
unnamed: R65.2, R66.1, U10.1
unnamed: R300.2, R301.1
unnamed: R301.2, R302.1
unnamed: R302.2, R303.1
unnamed: R310.2, R311.1
unnamed: R311.2, R312.1
unnamed: R312.2, R313.1
unnamed: R320.2, R321.1
unnamed: R321.2, R322.1
unnamed: R322.2, R323.1
unnamed: R330.2, R331.1
unnamed: R331.2, R332.1
unnamed: R332.2, R333.1
unnamed: R340.2, R341.1
unnamed: R341.2, R342.1
unnamed: R342.2, R343.1
unnamed: R350.2, R351.1
unnamed: R351.2, R352.1
unnamed: R352.2, R353.1
unnamed: U8.1, U8.2 (-)
unnamed: C90.1, R90.2, R91.1, U8.5 (+)
unnamed: C93.1, R93.1, U8.6 (-)
unnamed: R51.1, R52.1, U9.2 (-)
unnamed: R56.1, R57.1, U9.6 (-)
unnamed: R64.1, R65.1, U10.2 (-)
unnamed: U10.6 (-), U10.7
VREF_MID: C91.1, D50.1 (A1), D51.1 (A1), D52.1 (A1), J7.2, J7.4, J7.6, R50.2, R51.2, R55.2, R56.2, R59.2, R64.2, R92.2, R93.2, R304.2, R314.2, R324.2, R334.2, R344.2, R354.2

Notes on the sheet:
6x AC voltage dividers (/237, biased at VREF_MID), 3x CT burden+amp, 1.65V buffered midpoint. N terminals tie to board GND.
J5: GEN L1 L2 L3 N (415V 3ph star, 240V L-N)
J6: MAINS L1 L2 L3 N
J7: CT1 S1/S2, CT2 S1/S2, CT3 S1/S2 (50:5 CTs on load cables; 25kVA/415V = 34.8A full load)

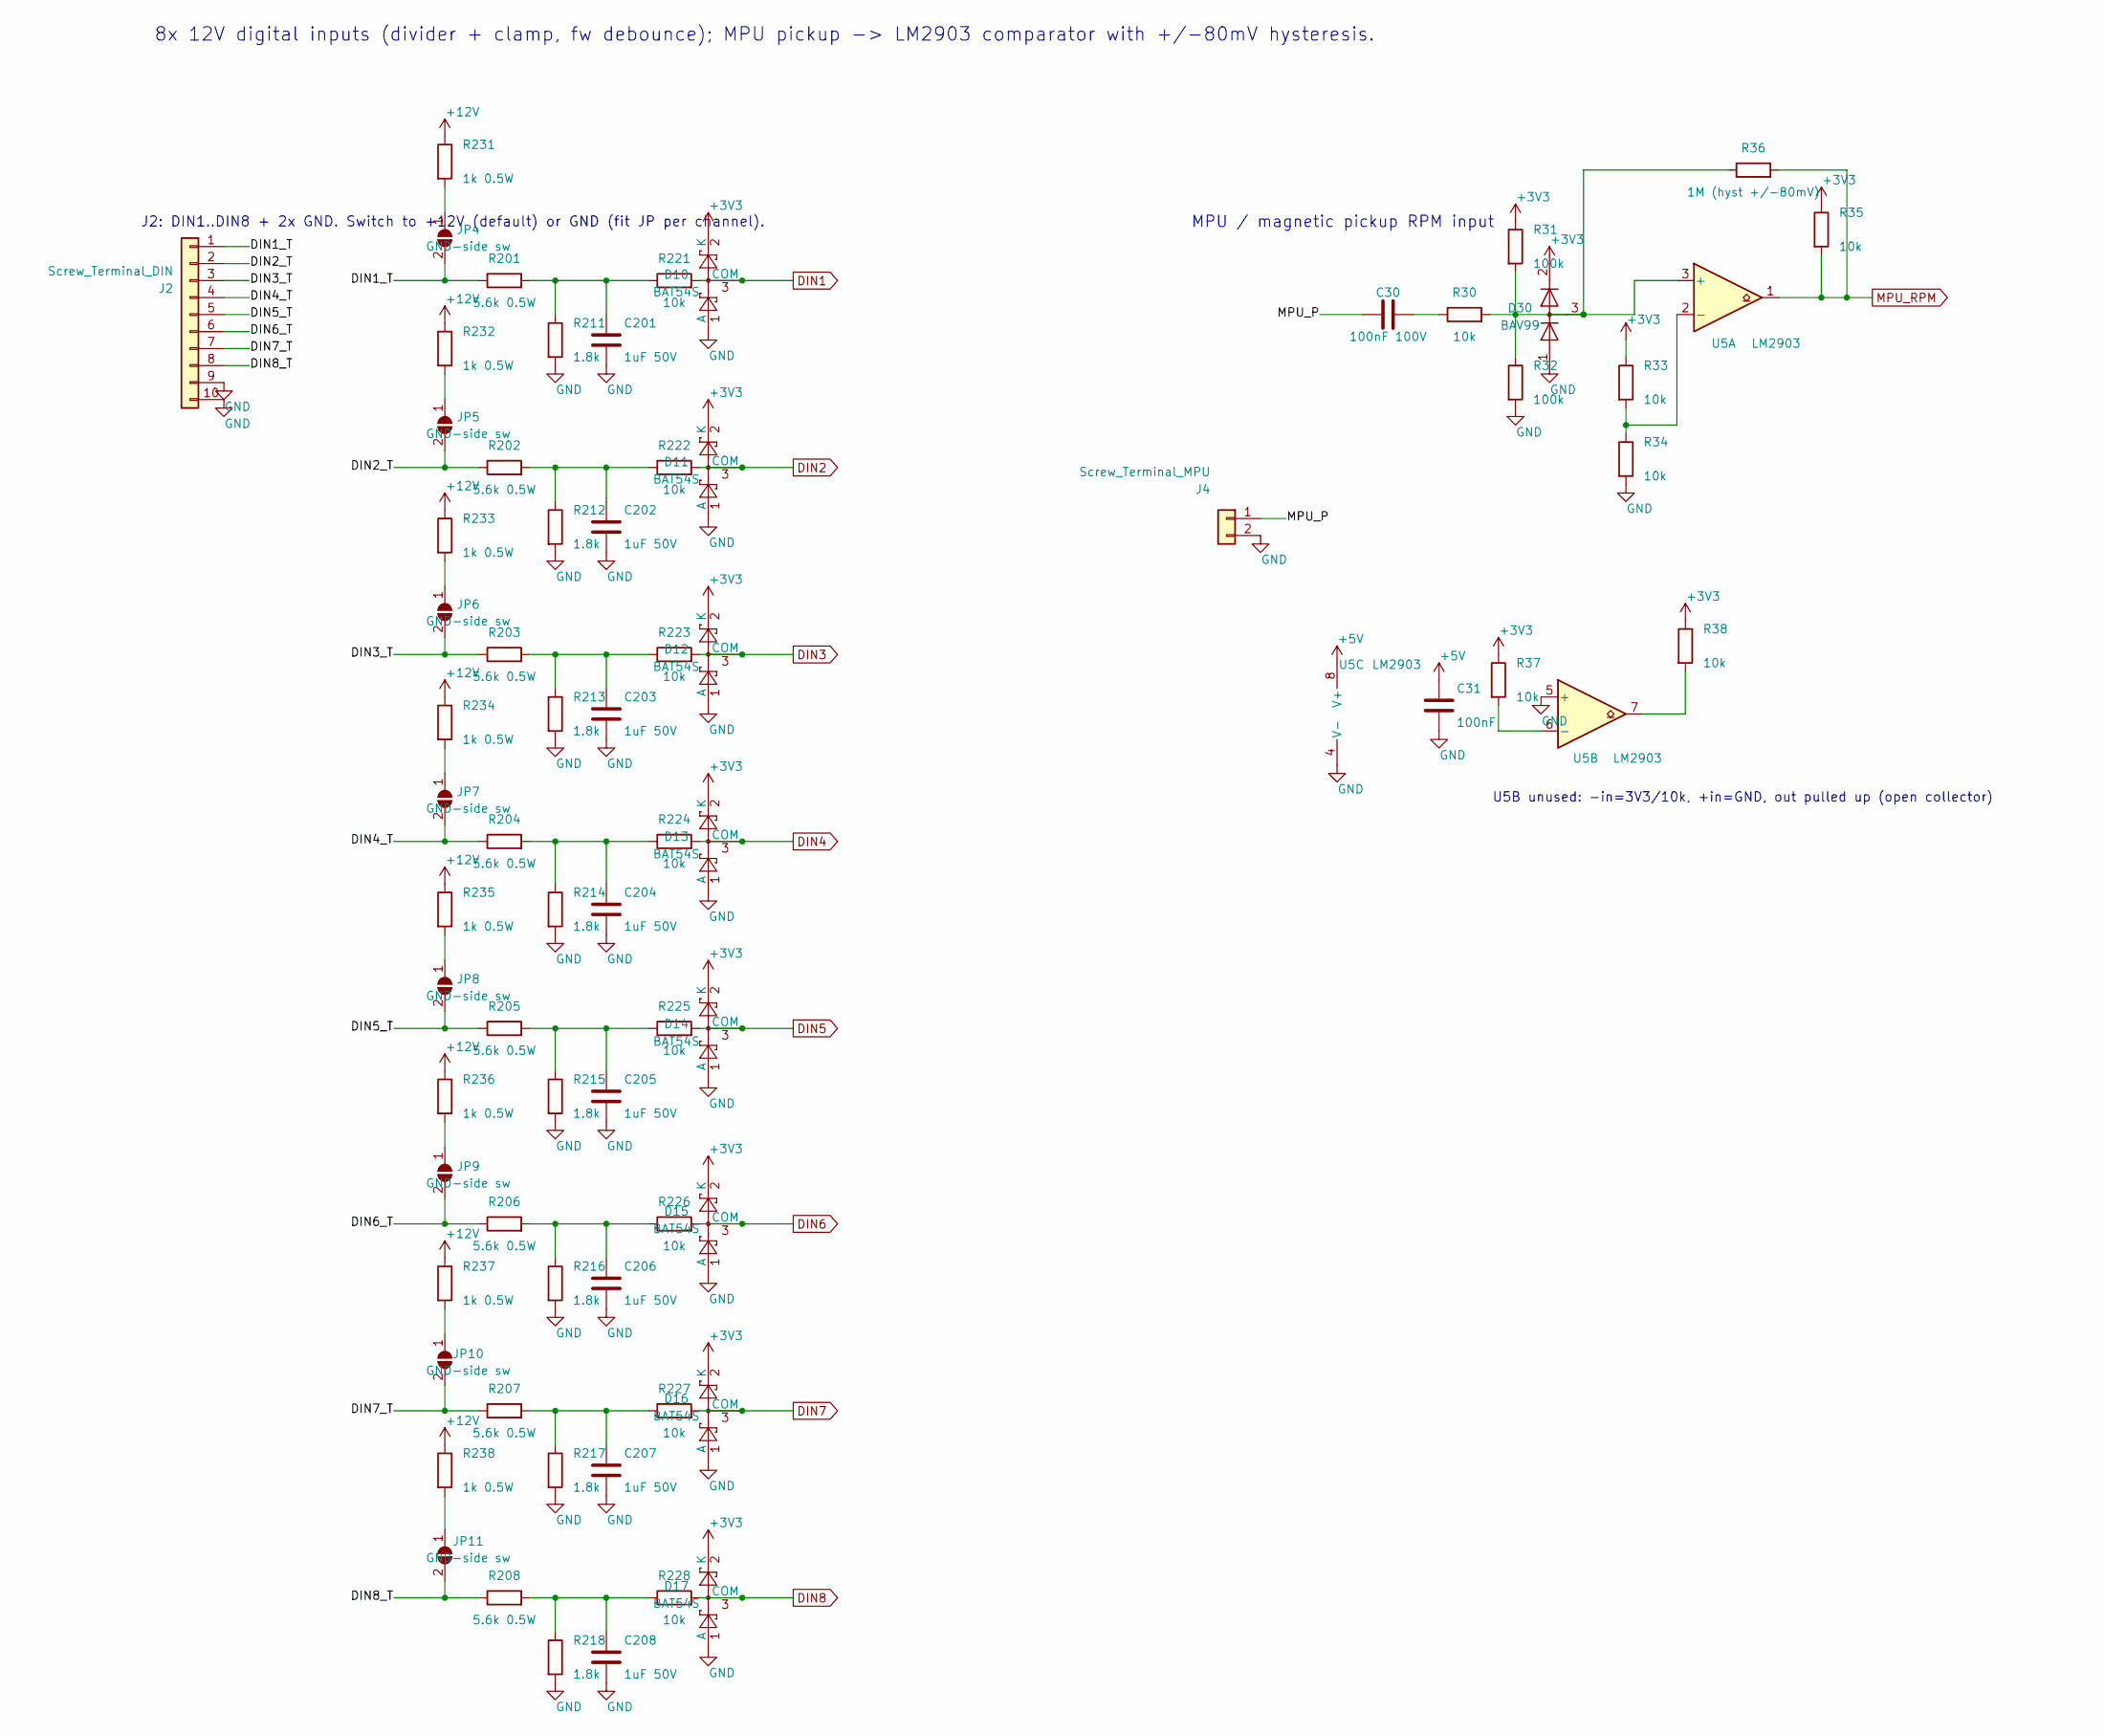
[picture p54: schematic digital.kicad_sch]

Parts:
C30: 100nF 100V; C_0805_2012Metric
C31: 100nF; C_0603_1608Metric
C201, C202, C203, C204, C205, C206, C207, C208: 1uF 50V; C_0603_1608Metric
D10, D11, D12, D13, D14, D15, D16, D17: BAT54S; SOT-23
D30: BAV99; SOT-23
J2: Screw_Terminal_DIN; TerminalBlock_Phoenix_MKDS-1,5-10-5.08_1x10_P5.08mm_Horizon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
J4: Screw_Terminal_MPU; TerminalBlock_Phoenix_MKDS-1,5-2-5.08_1x02_P5.08mm_Horizont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
JP4, JP5, JP6, JP7, JP8, JP9, JP10, JP11: GND-side sw; SolderJumper-2_P1.3mm_Open_RoundedPad1.0x1.5mm
R30, R33, R34, R35, R37, R38, R221, R222, R223, R224, R225, R226, R227, R228: 10k; R_0603_1608Metric
R31, R32: 100k; R_0603_1608Metric
R36: 1M (hyst +/-80mV); R_0603_1608Metric
R201, R202, R203, R204, R205, R206, R207, R208: 5.6k 0.5W; R_1210_3225Metric
R211, R212, R213, R214, R215, R216, R217, R218: 1.8k; R_0603_1608Metric
R231, R232, R233, R234, R235, R236, R237, R238: 1k 0.5W; R_1210_3225Metric
U5: LM2903; SOIC-8_3.9x4.9mm_P1.27mm

Connections:
+3V3: D10.2 (K), D11.2 (K), D12.2 (K), D13.2 (K), D14.2 (K), D15.2 (K), D16.2 (K), D17.2 (K), D30.2 (A), R31.1, R33.1, R35.1, R37.1, R38.1; also elsewhere on the board
+5V: C31.1, U5.8 (V+); also elsewhere on the board
+12V: R231.1, R232.1, R233.1, R234.1, R235.1, R236.1, R237.1, R238.1; also elsewhere on the board
/Digital inputs + MPU/DIN1_T: J2.1, JP4.2 (B), R201.1
/Digital inputs + MPU/DIN2_T: J2.2, JP5.2 (B), R202.1
/Digital inputs + MPU/DIN3_T: J2.3, JP6.2 (B), R203.1
/Digital inputs + MPU/DIN4_T: J2.4, JP7.2 (B), R204.1
/Digital inputs + MPU/DIN5_T: J2.5, JP8.2 (B), R205.1
/Digital inputs + MPU/DIN6_T: J2.6, JP9.2 (B), R206.1
/Digital inputs + MPU/DIN7_T: J2.7, JP10.2 (B), R207.1
/Digital inputs + MPU/DIN8_T: J2.8, JP11.2 (B), R208.1
/Digital inputs + MPU/MPU_P: C30.1, J4.1
DIN1: D10.3 (COM), R221.2; also elsewhere on the board
DIN2: D11.3 (COM), R222.2; also elsewhere on the board
DIN3: D12.3 (COM), R223.2; also elsewhere on the board
DIN4: D13.3 (COM), R224.2; also elsewhere on the board
DIN5: D14.3 (COM), R225.2; also elsewhere on the board
DIN6: D15.3 (COM), R226.2; also elsewhere on the board
DIN7: D16.3 (COM), R227.2; also elsewhere on the board
DIN8: D17.3 (COM), R228.2; also elsewhere on the board
GND: C31.2, C201.2, C202.2, C203.2, C204.2, C205.2, C206.2, C207.2, C208.2, D10.1 (A), D11.1 (A), D12.1 (A), D13.1 (A), D14.1 (A), D15.1 (A), D16.1 (A), D17.1 (A), D30.1 (K), J2.9, J2.10, J4.2, R32.2, R34.2, R211.2, R212.2, R213.2, R214.2, R215.2, R216.2, R217.2, R218.2, U5.4 (V-), U5.5 (+); also elsewhere on the board
MPU_RPM: R35.2, R36.2, U5.1; also elsewhere on the board
unnamed: C30.2, R30.1
unnamed: C201.1, R201.2, R211.1, R221.1
unnamed: C202.1, R202.2, R212.1, R222.1
unnamed: C203.1, R203.2, R213.1, R223.1
unnamed: C204.1, R204.2, R214.1, R224.1
unnamed: C205.1, R205.2, R215.1, R225.1
unnamed: C206.1, R206.2, R216.1, R226.1
unnamed: C207.1, R207.2, R217.1, R227.1
unnamed: C208.1, R208.2, R218.1, R228.1
unnamed: JP4.1 (A), R231.2
unnamed: JP5.1 (A), R232.2
unnamed: JP6.1 (A), R233.2
unnamed: JP7.1 (A), R234.2
unnamed: JP8.1 (A), R235.2
unnamed: JP9.1 (A), R236.2
unnamed: JP10.1 (A), R237.2
unnamed: JP11.1 (A), R238.2
unnamed: R38.2, U5.7
unnamed: D30.3 (K), R30.2, R31.2, R32.1, R36.1, U5.3 (+)
unnamed: R33.2, R34.1, U5.2 (-)
unnamed: R37.2, U5.6 (-)

Notes on the sheet:
8x 12V digital inputs (divider + clamp, fw debounce); MPU pickup -> LM2903 comparator with +/-80mV hysteresis.
J2: DIN1..DIN8 + 2x GND. Switch to +12V (default) or GND (fit JP per channel).
MPU / magnetic pickup RPM input
U5B unused: -in=3V3/10k, +in=GND, out pulled up (open collector)
