mohan4220/ecu/hardware/kicad/ecu25-main/ecu25-main.kicad_pcb

## KiCad design hardware/kicad/ecu25-main/ecu25-main.kicad_pcb (continued)

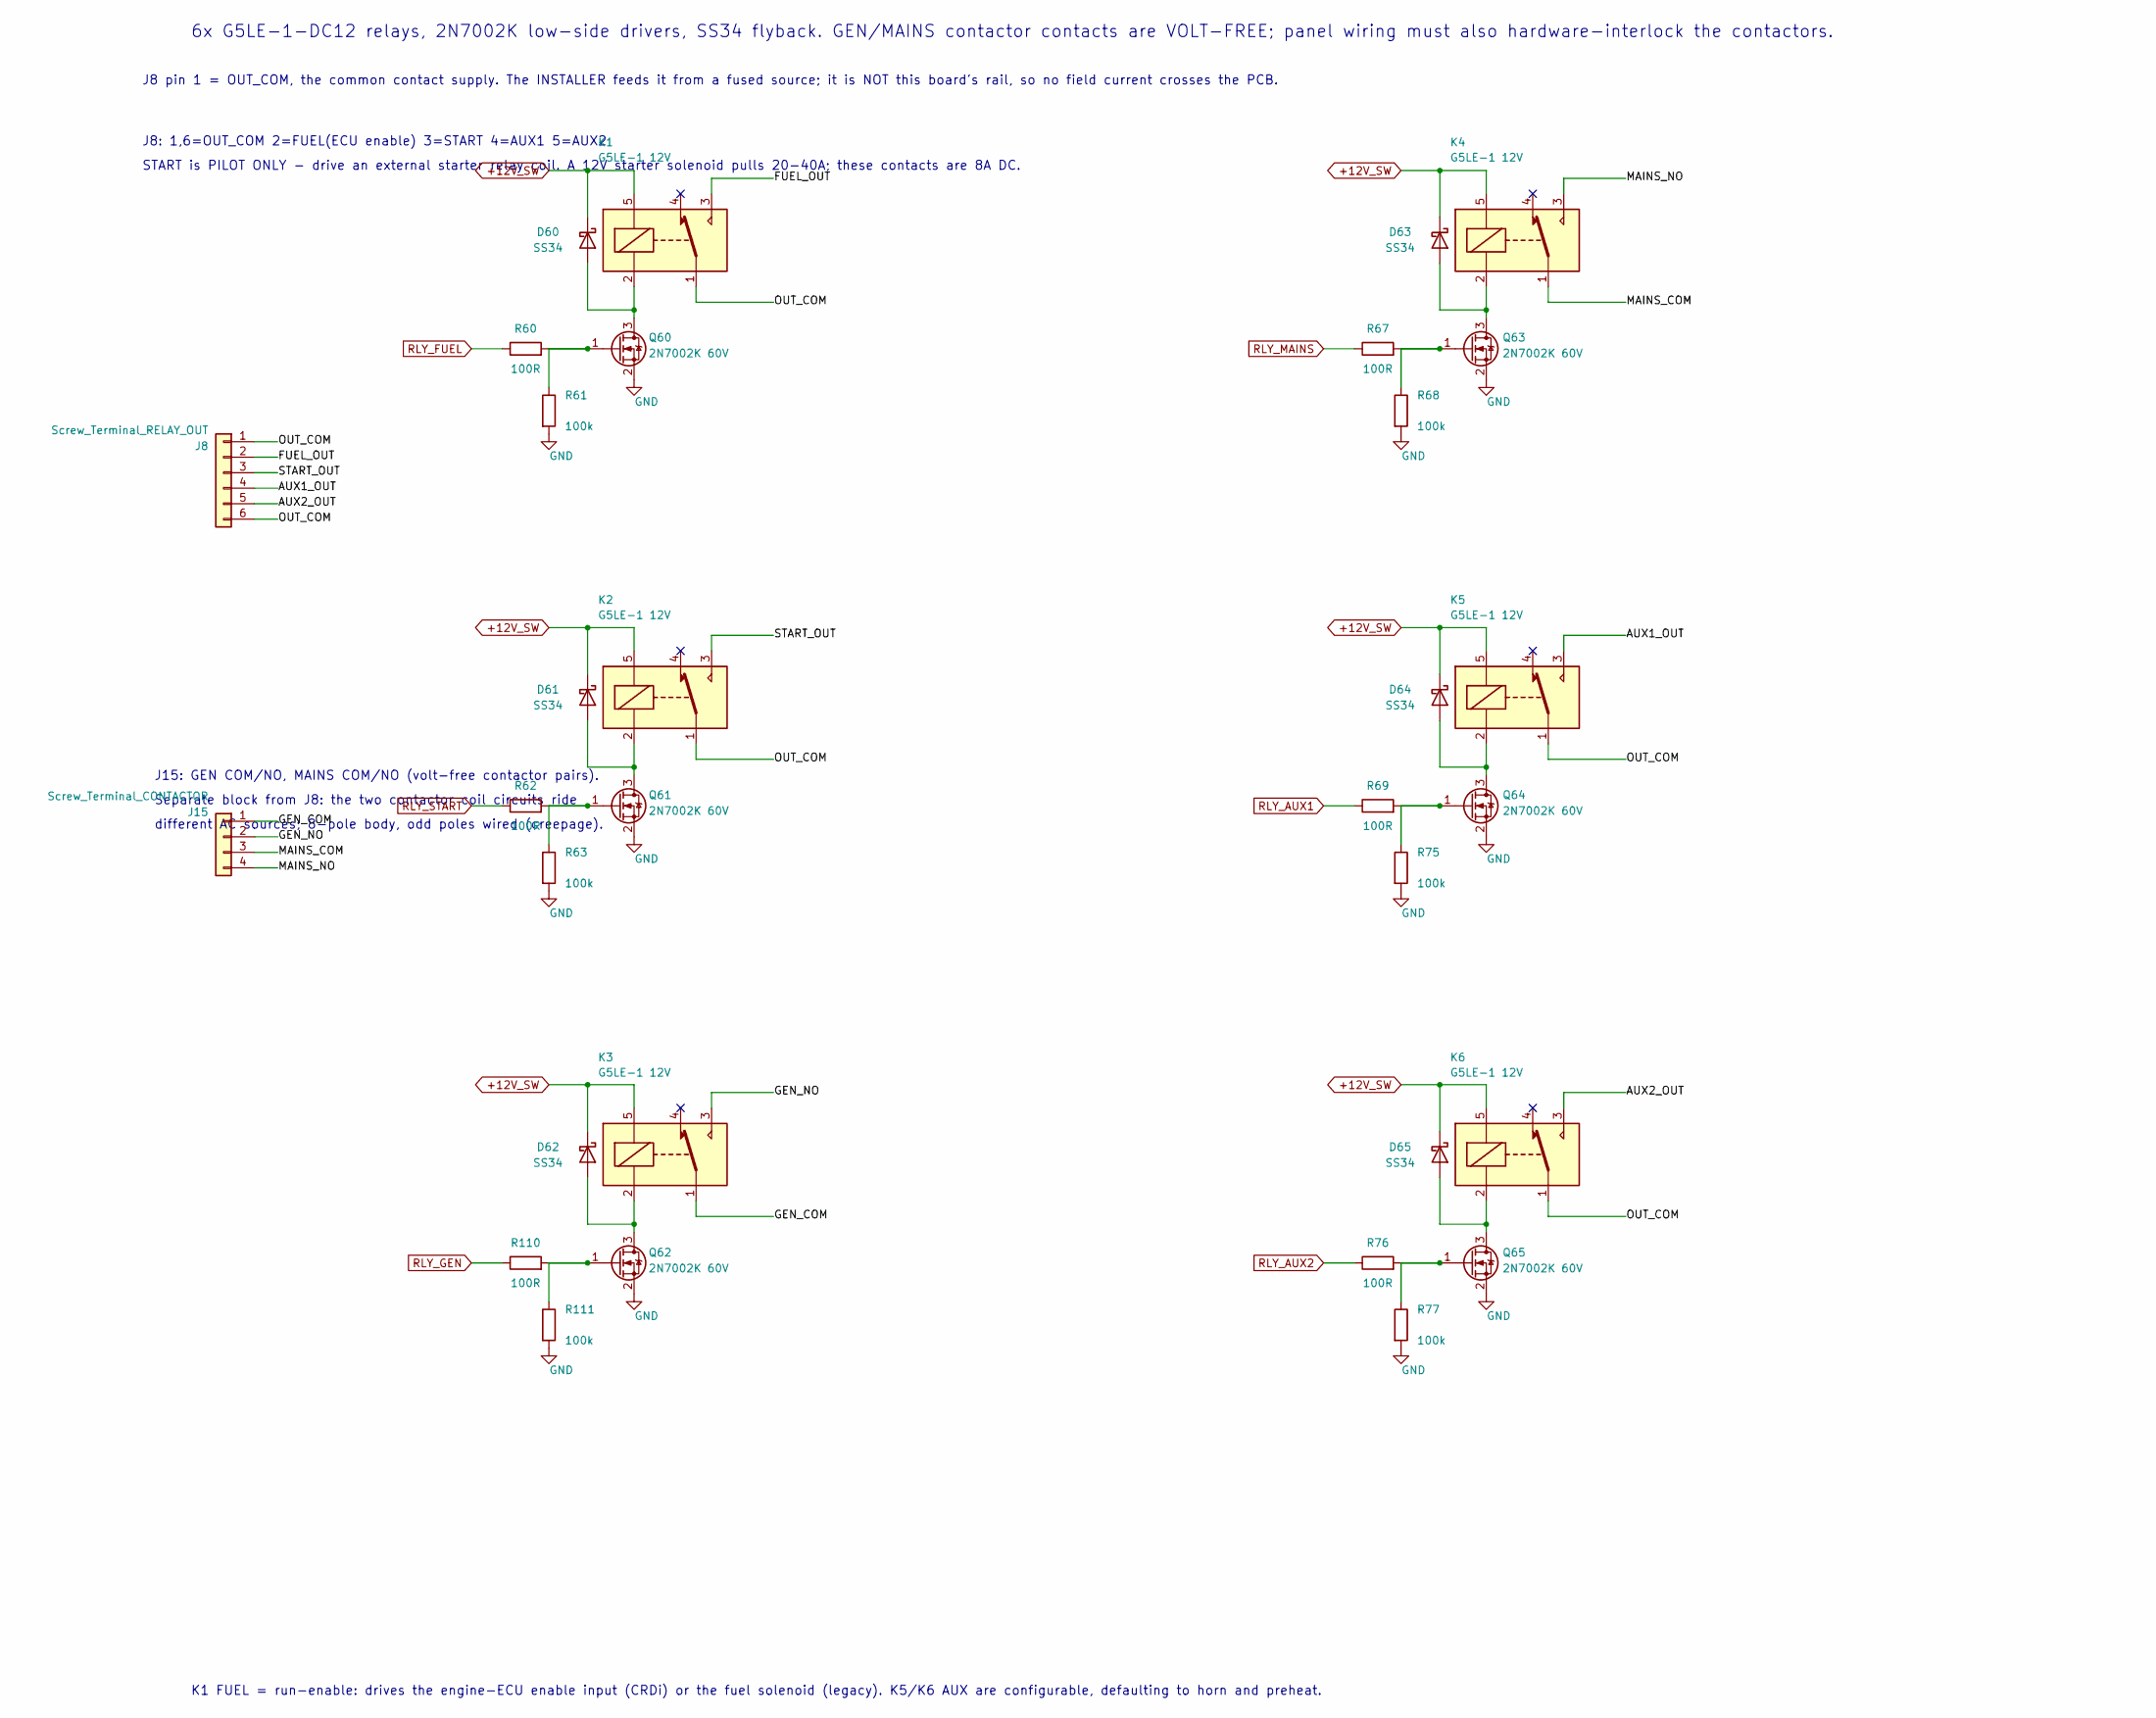
[picture p55: schematic relays.kicad_sch]

Parts:
D60, D61, D62, D63, D64, D65: SS34; D_SMA
J8: Screw_Terminal_RELAY_OUT; TerminalBlock_Phoenix_MKDS-3-6-5.08_1x06_P5.08mm_Horizontal
J15: Screw_Terminal_CONTACTOR; TerminalBlock_Phoenix_MKDS-3-8-5.08_1x08_P5.08mm_Horizontal
K1, K2, K3, K4, K5, K6: G5LE-1 12V; Relay_SPDT_Omron-G5LE-1
Q60, Q61, Q62, Q63, Q64, Q65: 2N7002K 60V; SOT-23
R60, R62, R67, R69, R76, R110: 100R; R_0603_1608Metric
R61, R63, R68, R75, R77, R111: 100k; R_0603_1608Metric

Connections:
+12V_SW: D60.1 (K), D61.1 (K), D62.1 (K), D63.1 (K), D64.1 (K), D65.1 (K), K1.5, K2.5, K3.5, K4.5, K5.5, K6.5; also elsewhere on the board
/Relay drivers/AUX1_OUT: J8.4, K5.3
/Relay drivers/AUX2_OUT: J8.5, K6.3
/Relay drivers/FUEL_OUT: J8.2, K1.3
/Relay drivers/GEN_COM: J15.1, K3.1
/Relay drivers/MAINS_NO: J15.4, J15.7, K4.3
/Relay drivers/OUT_COM: J8.1, J8.6, K1.1, K2.1, K5.1, K6.1
/Relay drivers/START_OUT: J8.3, K2.3
GND: Q60.2 (S), Q61.2 (S), Q62.2 (S), Q63.2 (S), Q64.2 (S), Q65.2 (S), R61.2, R63.2, R68.2, R75.2, R77.2, R111.2; also elsewhere on the board
unnamed: D60.2 (A), K1.2, Q60.3 (D)
unnamed: D61.2 (A), K2.2, Q61.3 (D)
unnamed: D62.2 (A), K3.2, Q62.3 (D)
unnamed: D63.2 (A), K4.2, Q63.3 (D)
unnamed: D64.2 (A), K5.2, Q64.3 (D)
unnamed: D65.2 (A), K6.2, Q65.3 (D)
unnamed: Q60.1 (G), R60.2, R61.1
unnamed: Q61.1 (G), R62.2, R63.1
unnamed: Q62.1 (G), R110.2, R111.1
unnamed: Q63.1 (G), R67.2, R68.1
unnamed: Q64.1 (G), R69.2, R75.1
unnamed: Q65.1 (G), R76.2, R77.1
RLY_AUX1: R69.1; also elsewhere on the board
RLY_AUX2: R76.1; also elsewhere on the board
RLY_FUEL: R60.1; also elsewhere on the board
RLY_GEN: R110.1; also elsewhere on the board
RLY_MAINS: R67.1; also elsewhere on the board
RLY_START: R62.1; also elsewhere on the board

Notes on the sheet:
6x G5LE-1-DC12 relays, 2N7002K low-side drivers, SS34 flyback. GEN/MAINS contactor contacts are VOLT-FREE; panel wiring must also hardware-interlock the contactors.
J8 pin 1 = OUT_COM, the common contact supply. The INSTALLER feeds it from a fused source; it is NOT this board's rail, so no field current crosses the PCB.
J8: 1,6=OUT_COM 2=FUEL(ECU enable) 3=START 4=AUX1 5=AUX2
START is PILOT ONLY - drive an external starter relay coil. A 12V starter solenoid pulls 20-40A; these contacts are 8A DC.
J15: GEN COM/NO, MAINS COM/NO (volt-free contactor pairs).
Separate block from J8: the two contactor coil circuits ride
different AC sources; 8-pole body, odd poles wired (creepage).
K1 FUEL = run-enable: drives the engine-ECU enable input (CRDi) or the fuel solenoid (legacy). K5/K6 AUX are configurable, defaulting to horn and preheat.

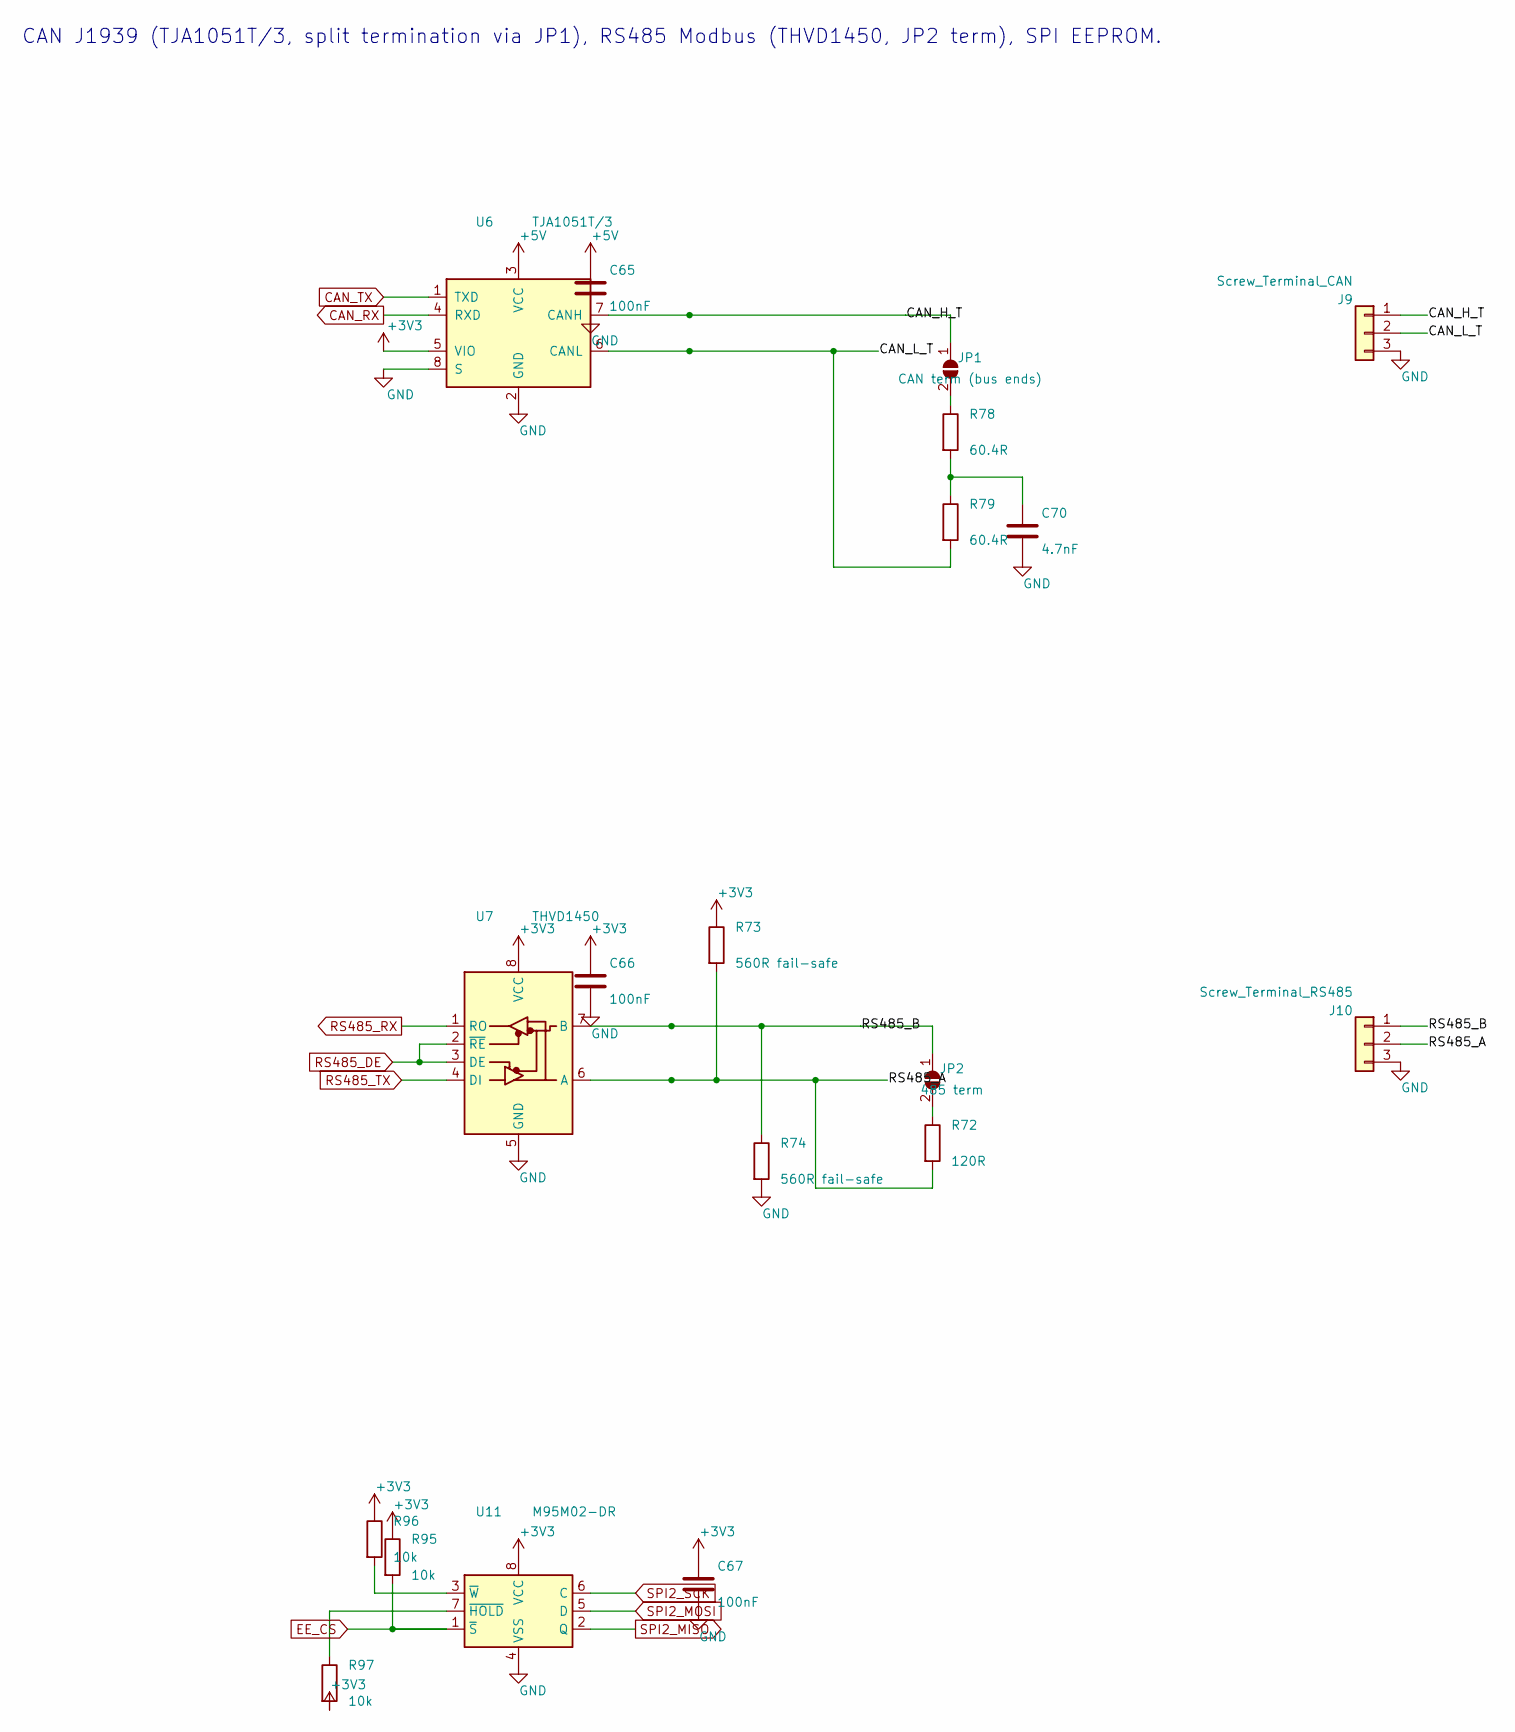
[picture p56: schematic comms.kicad_sch]

Parts:
C65, C66, C67: 100nF; C_0603_1608Metric
C70: 4.7nF; C_0603_1608Metric
J9: Screw_Terminal_CAN; TerminalBlock_Phoenix_MKDS-1,5-3-5.08_1x03_P5.08mm_Horizont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
J10: Screw_Terminal_RS485; TerminalBlock_Phoenix_MKDS-1,5-3-5.08_1x03_P5.08mm_Horizont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
JP1: CAN term (bus ends); SolderJumper-2_P1.3mm_Open_RoundedPad1.0x1.5mm
JP2: 485 term; SolderJumper-2_P1.3mm_Open_RoundedPad1.0x1.5mm
R72: 120R; R_0603_1608Metric
R73, R74: 560R fail-safe; R_0603_1608Metric
R78, R79: 60.4R; R_0603_1608Metric
R95, R96, R97: 10k; R_0603_1608Metric
U6: TJA1051T/3; SOIC-8_3.9x4.9mm_P1.27mm
U7: THVD1450; SOIC-8_3.9x4.9mm_P1.27mm
U11: M95M02-DR; SOIC-8_3.9x4.9mm_P1.27mm

Connections:
+3V3: C66.1, C67.1, R73.1, R95.1, R96.1, R97.2, U6.5 (VIO), U7.8 (VCC), U11.8 (VCC); also elsewhere on the board
+5V: C65.1, U6.3 (VCC); also elsewhere on the board
/Comms/CAN_H_T: J9.1, JP1.1 (A), U6.7 (CANH)
/Comms/CAN_L_T: J9.2, R79.2, U6.6 (CANL)
/Comms/RS485_A: J10.2, R72.2, R73.2, U7.6 (A)
/Comms/RS485_B: J10.1, JP2.1 (A), R74.1, U7.7 (B)
CAN_RX: U6.4 (RXD); also elsewhere on the board
CAN_TX: U6.1 (TXD); also elsewhere on the board
EE_CS: R95.2, U11.1 (~S); also elsewhere on the board
GND: C65.2, C66.2, C67.2, C70.2, J9.3, J10.3, R74.2, U6.2 (GND), U6.8 (S), U7.5 (GND), U11.4 (VSS); also elsewhere on the board
unnamed: C70.1, R78.2, R79.1
unnamed: JP1.2 (B), R78.1
unnamed: JP2.2 (B), R72.1
unnamed: R97.1, U11.7 (~HOLD)
unnamed: R96.2, U11.3 (~W)
RS485_DE: U7.2 (~RE), U7.3 (DE); also elsewhere on the board
RS485_RX: U7.1 (RO); also elsewhere on the board
RS485_TX: U7.4 (DI); also elsewhere on the board
SPI2_MISO: U11.2 (Q); also elsewhere on the board
SPI2_MOSI: U11.5 (D); also elsewhere on the board
SPI2_SCK: U11.6 (C); also elsewhere on the board

Notes on the sheet:
CAN J1939 (TJA1051T/3, split termination via JP1), RS485 Modbus (THVD1450, JP2 term), SPI EEPROM.

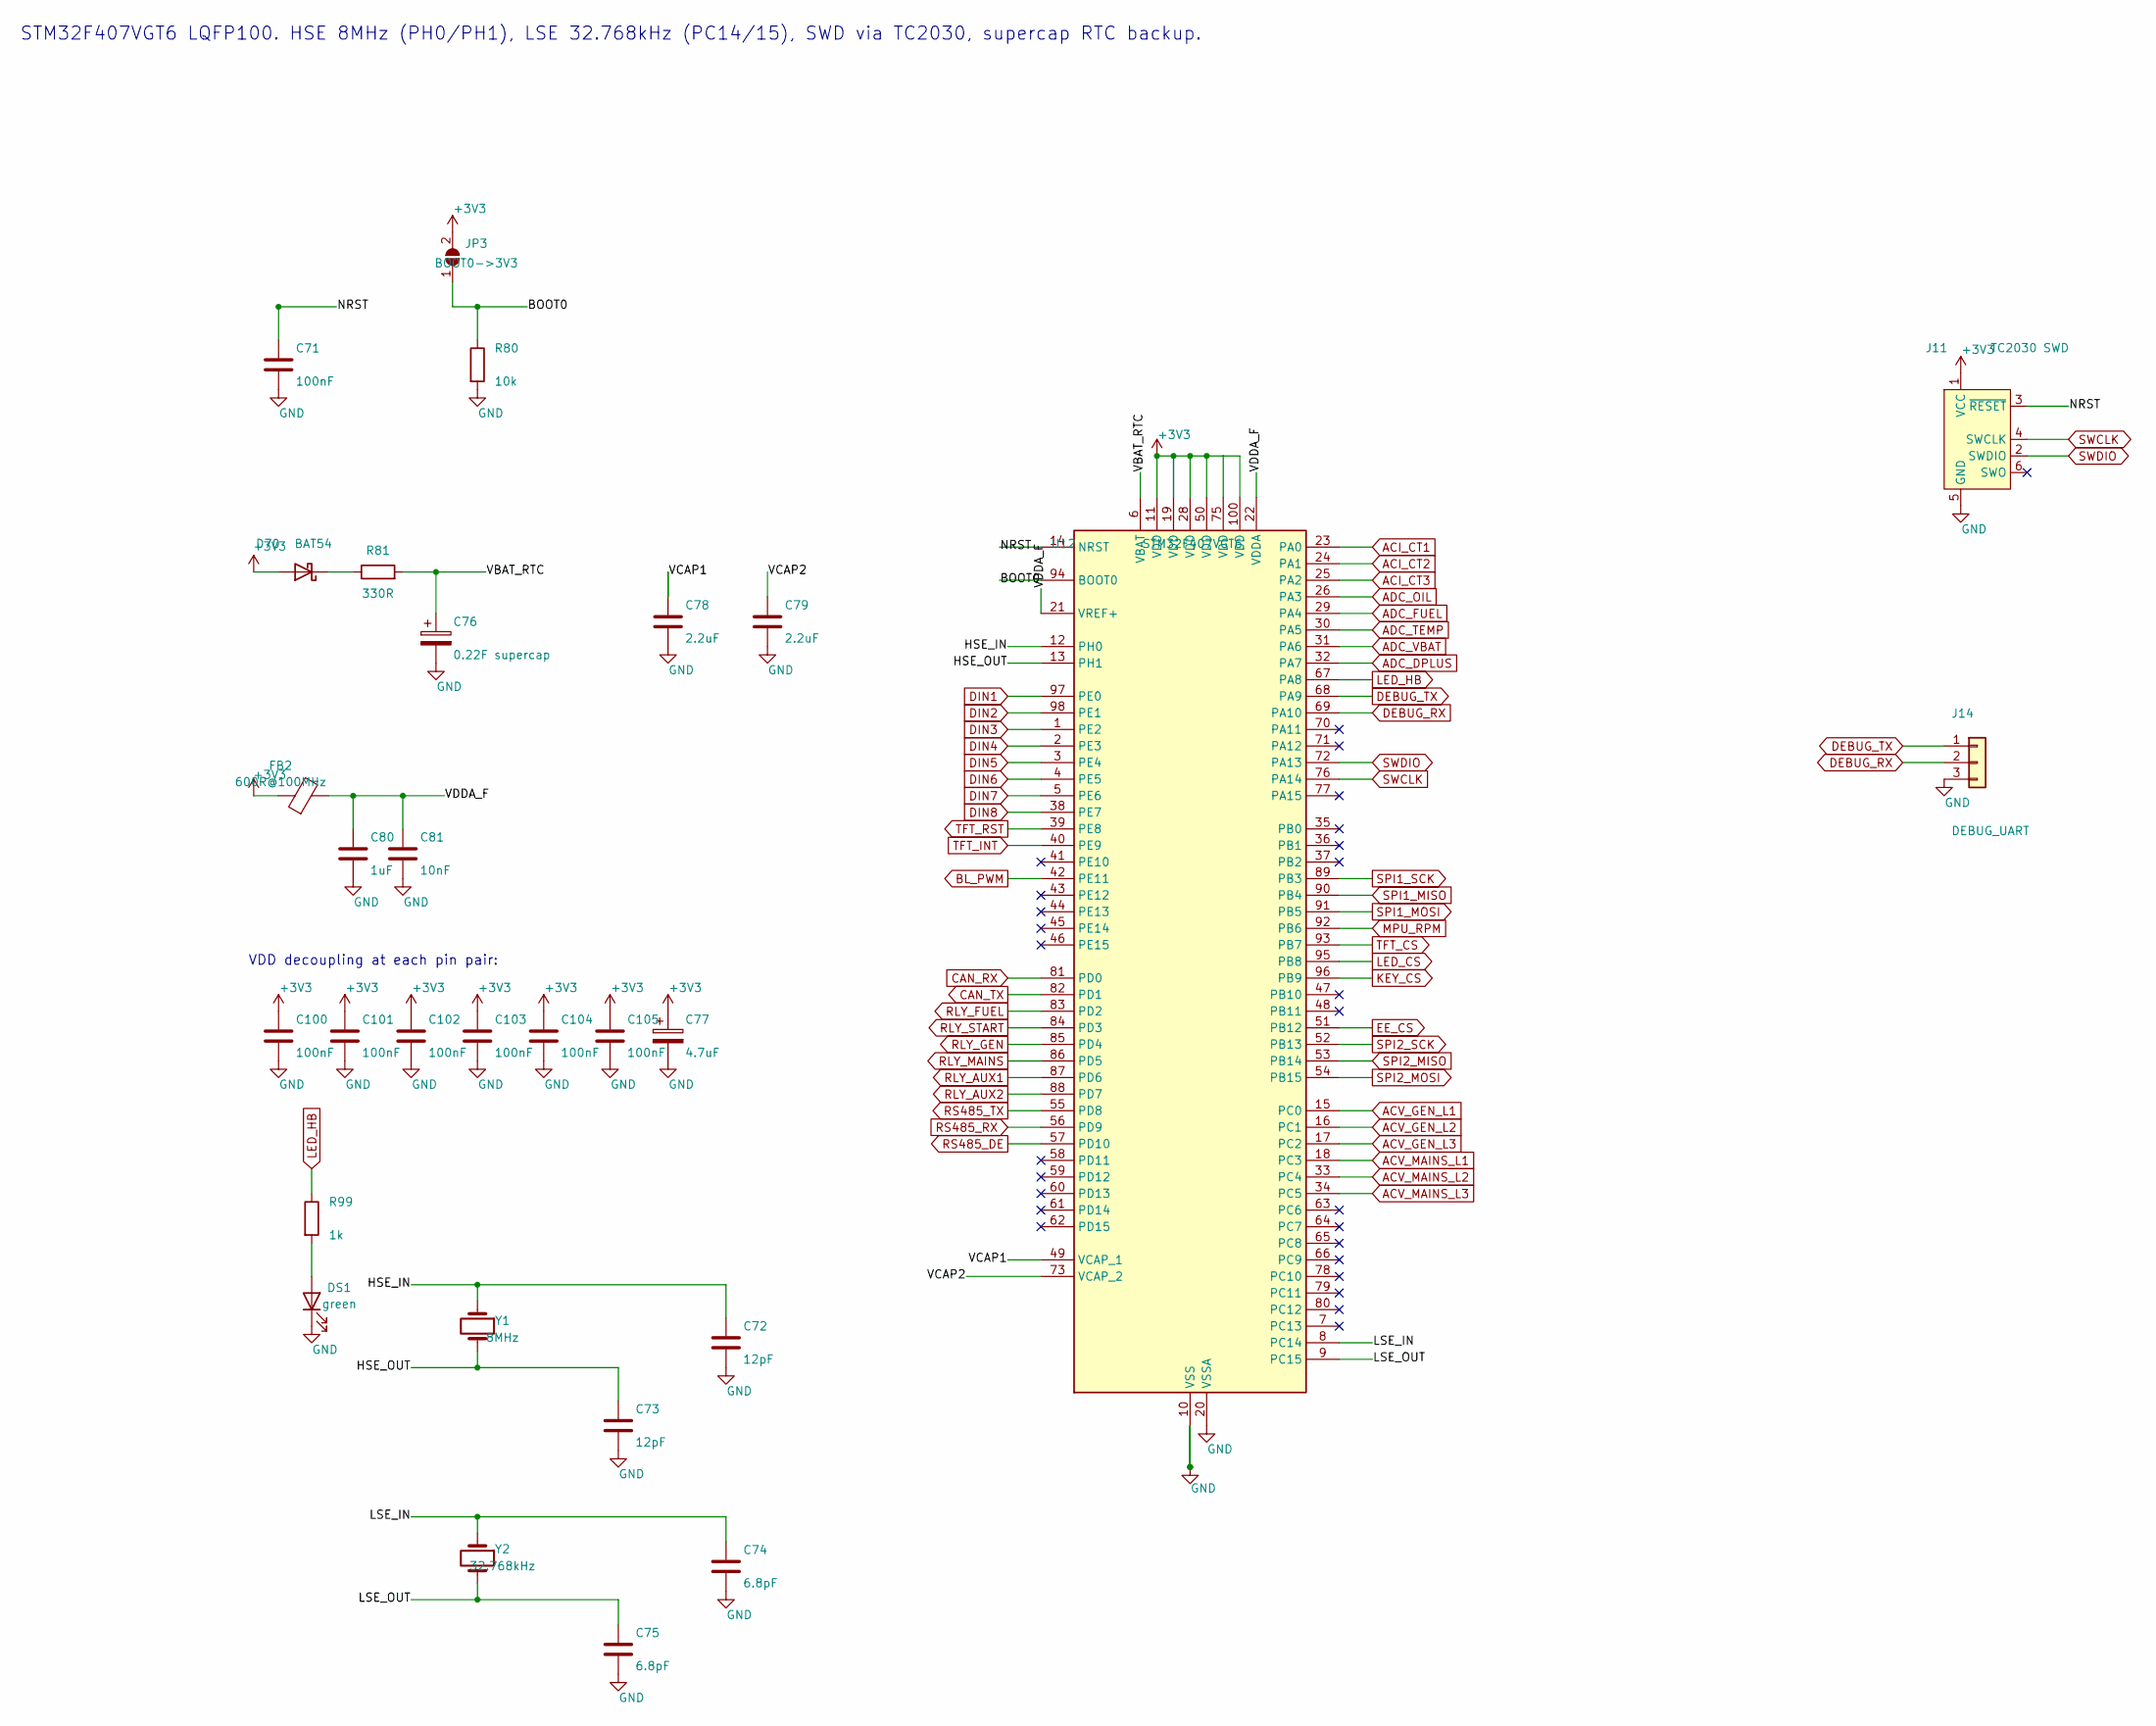
[picture p57: schematic mcu.kicad_sch]

Parts:
C71, C100, C101, C102, C103, C104, C105: 100nF; C_0603_1608Metric
C72, C73: 12pF; C_0603_1608Metric
C74, C75: 6.8pF; C_0603_1608Metric
C76: 0.22F supercap; CP_Radial_D10.0mm_P5.00mm
C77: 4.7uF; CP_Elec_4x5.4
C78, C79: 2.2uF; C_0603_1608Metric
C80: 1uF; C_0603_1608Metric
C81: 10nF; C_0603_1608Metric
D70: BAT54; D_SOD-123
DS1: green; LED_0805_2012Metric
FB2: 600R@100MHz; L_0603_1608Metric
J11: TC2030 SWD; Tag-Connect_TC2030-IDC-NL_2x03_P1.27mm_Vertical
J14: DEBUG_UART; PinHeader_1x03_P2.54mm_Vertical
JP3: BOOT0->3V3; SolderJumper-2_P1.3mm_Open_RoundedPad1.0x1.5mm
R80: 10k; R_0603_1608Metric
R81: 330R; R_0603_1608Metric
R99: 1k; R_0603_1608Metric
U12: STM32F407VGT6; LQFP-100_14x14mm_P0.5mm
Y1: 8MHz; Crystal_SMD_HC49-SD
Y2: 32.768kHz; Crystal_SMD_3215-2Pin_3.2x1.5mm

Connections:
+3V3: C77.1, C100.1, C101.1, C102.1, C103.1, C104.1, C105.1, D70.2 (A), FB2.1, J11.1 (VCC), JP3.2 (B), U12.11 (VDD), U12.19 (VDD), U12.28 (VDD), U12.50 (VDD), U12.75 (VDD), U12.100 (VDD); also elsewhere on the board
/MCU/BOOT0: JP3.1 (A), R80.1, U12.94 (BOOT0)
/MCU/HSE_IN: C72.1, U12.12 (PH0), Y1.1
/MCU/HSE_OUT: C73.1, U12.13 (PH1), Y1.2
/MCU/LSE_IN: C74.1, U12.8 (PC14), Y2.1
/MCU/LSE_OUT: C75.1, U12.9 (PC15), Y2.2
/MCU/NRST: C71.1, J11.3 (~RESET), U12.14 (NRST)
/MCU/VBAT_RTC: C76.1, R81.2, U12.6 (VBAT)
/MCU/VCAP1: C78.1, U12.49 (VCAP_1)
/MCU/VCAP2: C79.1, U12.73 (VCAP_2)
/MCU/VDDA_F: C80.1, C81.1, FB2.2, U12.21 (VREF+), U12.22 (VDDA)
ACI_CT1: U12.23 (PA0); also elsewhere on the board
ACI_CT2: U12.24 (PA1); also elsewhere on the board
ACI_CT3: U12.25 (PA2); also elsewhere on the board
ACV_GEN_L1: U12.15 (PC0); also elsewhere on the board
ACV_GEN_L2: U12.16 (PC1); also elsewhere on the board
ACV_GEN_L3: U12.17 (PC2); also elsewhere on the board
ACV_MAINS_L1: U12.18 (PC3); also elsewhere on the board
ACV_MAINS_L2: U12.33 (PC4); also elsewhere on the board
ACV_MAINS_L3: U12.34 (PC5); also elsewhere on the board
ADC_DPLUS: U12.32 (PA7); also elsewhere on the board
ADC_FUEL: U12.29 (PA4); also elsewhere on the board
ADC_OIL: U12.26 (PA3); also elsewhere on the board
ADC_TEMP: U12.30 (PA5); also elsewhere on the board
ADC_VBAT: U12.31 (PA6); also elsewhere on the board
BL_PWM: U12.42 (PE11); also elsewhere on the board
CAN_RX: U12.81 (PD0); also elsewhere on the board
CAN_TX: U12.82 (PD1); also elsewhere on the board
DEBUG_RX: J14.2, U12.69 (PA10)
DEBUG_TX: J14.1, U12.68 (PA9)
DIN1: U12.97 (PE0); also elsewhere on the board
DIN2: U12.98 (PE1); also elsewhere on the board
DIN3: U12.1 (PE2); also elsewhere on the board
DIN4: U12.2 (PE3); also elsewhere on the board
DIN5: U12.3 (PE4); also elsewhere on the board
DIN6: U12.4 (PE5); also elsewhere on the board
DIN7: U12.5 (PE6); also elsewhere on the board
DIN8: U12.38 (PE7); also elsewhere on the board
EE_CS: U12.51 (PB12); also elsewhere on the board
GND: C71.2, C72.2, C73.2, C74.2, C75.2, C76.2, C77.2, C78.2, C79.2, C80.2, C81.2, C100.2, C101.2, C102.2, C103.2, C104.2, C105.2, DS1.1 (K), J11.5 (GND), J14.3, R80.2, U12.10 (VSS), U12.20 (VSSA), U12.27 (VSS), U12.74 (VSS), U12.99 (VSS); also elsewhere on the board
KEY_CS: U12.96 (PB9); also elsewhere on the board
LED_CS: U12.95 (PB8); also elsewhere on the board
LED_HB: R99.1, U12.67 (PA8)
MPU_RPM: U12.92 (PB6); also elsewhere on the board
unnamed: D70.1 (K), R81.1
unnamed: DS1.2 (A), R99.2
RLY_AUX1: U12.87 (PD6); also elsewhere on the board
RLY_AUX2: U12.88 (PD7); also elsewhere on the board
RLY_FUEL: U12.83 (PD2); also elsewhere on the board
RLY_GEN: U12.85 (PD4); also elsewhere on the board
RLY_MAINS: U12.86 (PD5); also elsewhere on the board
RLY_START: U12.84 (PD3); also elsewhere on the board
RS485_DE: U12.57 (PD10); also elsewhere on the board
RS485_RX: U12.56 (PD9); also elsewhere on the board
RS485_TX: U12.55 (PD8); also elsewhere on the board
SPI1_MISO: U12.90 (PB4); also elsewhere on the board
SPI1_MOSI: U12.91 (PB5); also elsewhere on the board
SPI1_SCK: U12.89 (PB3); also elsewhere on the board
SPI2_MISO: U12.53 (PB14); also elsewhere on the board
SPI2_MOSI: U12.54 (PB15); also elsewhere on the board
SPI2_SCK: U12.52 (PB13); also elsewhere on the board
SWCLK: J11.4 (SWCLK), U12.76 (PA14)
SWDIO: J11.2 (SWDIO), U12.72 (PA13)
TFT_CS: U12.93 (PB7); also elsewhere on the board
TFT_INT: U12.40 (PE9); also elsewhere on the board
TFT_RST: U12.39 (PE8); also elsewhere on the board

Notes on the sheet:
STM32F407VGT6 LQFP100. HSE 8MHz (PH0/PH1), LSE 32.768kHz (PC14/15), SWD via TC2030, supercap RTC backup.
VDD decoupling at each pin pair:

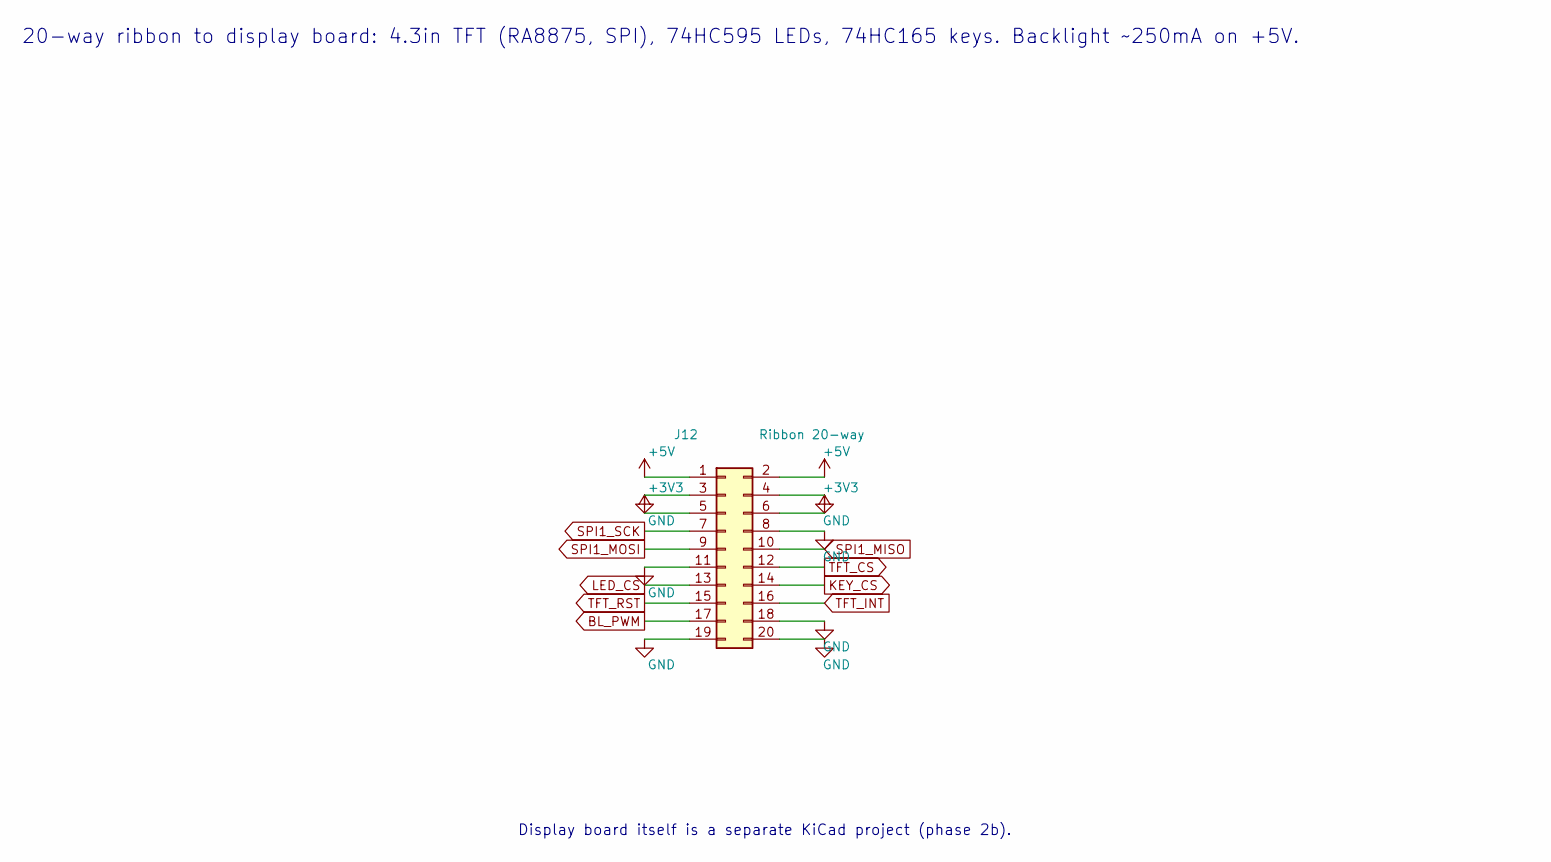
[picture p58: schematic display.kicad_sch]

Parts:
J12: Ribbon 20-way; IDC-Header_2x10-1MP_P2.54mm_Latch_Vertical

Connections:
+3V3: J12.5, J12.6; also elsewhere on the board
+5V: J12.1, J12.2; also elsewhere on the board
BL_PWM: J12.17; also elsewhere on the board
GND: J12.3, J12.4, J12.8, J12.11, J12.18, J12.19, J12.20, J12.MP; also elsewhere on the board
KEY_CS: J12.14; also elsewhere on the board
LED_CS: J12.13; also elsewhere on the board
SPI1_MISO: J12.10; also elsewhere on the board
SPI1_MOSI: J12.9; also elsewhere on the board
SPI1_SCK: J12.7; also elsewhere on the board
TFT_CS: J12.12; also elsewhere on the board
TFT_INT: J12.16; also elsewhere on the board
TFT_RST: J12.15; also elsewhere on the board

Notes on the sheet:
20-way ribbon to display board: 4.3in TFT (RA8875, SPI), 74HC595 LEDs, 74HC165 keys. Backlight ~250mA on +5V.
Display board itself is a separate KiCad project (phase 2b).

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
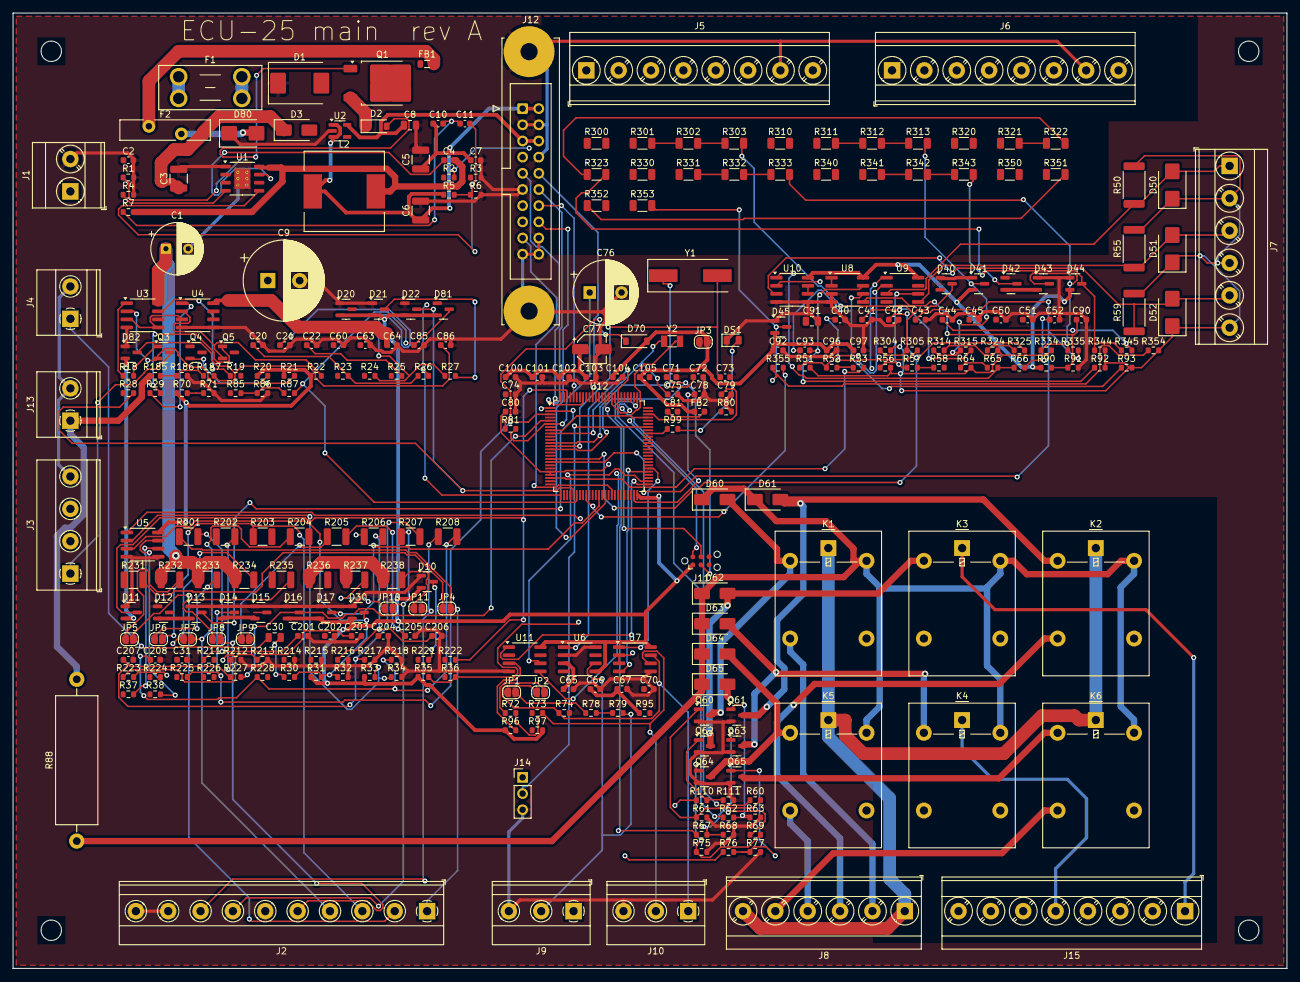
[picture p59: board ecu25-main.kicad_pcb from above]

Board: 2 copper layers, 200.0 x 150.0 mm, 309 parts (0 on the bottom side), 205 nets.

Other parts of the board:
H1, H2, H3, H4: MountingHole_3.2mm_M3
