mohan4220/ecu/(commit log)

2026-07-30 Add reference circuit diagrams with calculated values
    [ECU25.kicad_pcb, ECU25.kicad_sch]
2026-08-11 Rev A: engine confirmed common-rail; ECU-25 becomes J1939 supervisor with legacy mode
2026-08-11 Add block diagrams + missing circuits; apply independent design review fixes
    Review findings applied: TVS polarity on +24V_SW, STM32 VCAP caps,
    GND-side switch pull-up, LM2903 5V supply, V/I filter phase matching,
    CT burden 0.05R with TVS, 60V relay FET, supercap inrush limit,
    500mA LDO (TLV75533), VREF buffer feedback after isolation R.
    [generate.py]
2026-08-11 Add circuit guide (what/why/how/simulate per circuit) + second review fixes
    Second independent review corrected: R13 pull-up moved to terminal side
    (GND-side switches were undetectable), LM5164 RON=100k gives 300kHz not
    450kHz (ripple 0.40A), AC divider 5.62k -> clips at 276Vrms above the
    110% trip point, CT clip is 11.7A RMS (sqrt2 was dropped), realistic
    load-dump sim stimulus, sensitivity/part-number corrections.
    [generate.py]
2026-08-14 Upgrade display to 4.3in 480x272 color TFT with RA8875 over SPI
    Phone-size display per stakeholder input, matching modern CPCB IV+
    controller class. RA8875 carries framebuffer + drawing engine so the
    STM32F407 and SPI ribbon architecture stay unchanged; ribbon grows to
    20-way (adds 5V backlight, RA8875 control lines). UI moves to LVGL
    with PC-simulator-first development. Physical keys retained.
2026-08-15 Add SIL firmware: pure logic modules, plant model, 16-scenario test suite
    Core: engine_fsm (start sequencing, crank disconnect from rpm/oil/gen-Hz,
    rotation inhibit, fail-to-start/stop), protection engine (warning vs
    latched shutdown, qualification delays, arming windows), amf_fsm (mains
    qualification, chatter-free contactor logic), gcu_app supervisor with
    break-before-make dead time enforced on every handover path.
    SME-reviewed twice: two critical findings (dead-time bypass on fault
    paths, SHUTDOWN exit on lost rpm sensor) demonstrated by probe, fixed,
    and re-verified by probe. 117k assertions green; narrated AMF demo passes.
    [amf_fsm.c, amf_fsm.h, engine_fsm.c, engine_fsm.h, gcu_app.c, gcu_app.h, gcu_config.c, gcu_types.h]
2026-08-15 Add KiCad 7 main-board schematic: 8 subsystem sheets, generated from reviewed calc sheet
    - hardware/kicad/gen/kisch.py: schematic builder (symbol flattening,
    pin-exact placement, T-join wire splitting, KiCad 7 instances)
    - hardware/kicad/gen/gen_ecu25.py: full board capture — power, analog
    inputs, AC sensing, digital+MPU, relays, comms, MCU, display connector
    - 297 components, netlist validated: no orphan nets, no shorted devices,
    connectivity traced by script; annotation clean
    - STM32F407VGT6 pin assignment documented in hardware/kicad/README.md
    [ac_sense.kicad_sch, analog.kicad_sch, comms.kicad_sch, digital.kicad_sch, display.kicad_sch, ecu25-main.kicad_sch, mcu.kicad_sch, power.kicad_sch]
2026-08-16 Fix SME review findings: 3 critical, 6 major schematic faults
    Critical:
    - RON pin no longer shorted to GND (R4 moved off C3's column)
    - LM2903 MPU comparator +/- inputs unmerged (separate route columns)
    - Supercap charge diode D70 un-reversed (anode to +3V3)
    Major:
    - Buck UVLO divider restored (stray EN stub ended on C3 column = EN
    tied to +24V; stub removed)
    - RS485 fail-safe bias polarity corrected (pull-up A, pull-down B)
    - U8 spare op-amp unit placed and tied off (was floating on VREF die)
    - Heartbeat LED DS1 un-reversed
    - VREF_MID buffer dual feedback added (R93 DC path + C93 AC path)
    - D80 value SMBJ33A -> SMBJ33CA (bidirectional, matches symbol)
    Added netlist-level sweep check (sh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
    [ac_sense.kicad_sch, analog.kicad_sch, comms.kicad_sch, digital.kicad_sch, display.kicad_sch, ecu25-main.kicad_sch, mcu.kicad_sch, power.kicad_sch]
2026-08-16 Restore KiCad-managed project settings; generator no longer overwrites .kicad_pro
    [kisch.py]
2026-08-16 Add J1939 engine-ECU interface: PGN decode, DM1 lamps, address claim
    - core/j1939.c: pure-logic receiver for EEC1/EFL-P1/ET1/DD/DM1 with SPN
    scaling, per-value age timeouts, not-available (0xFB+) rejection, and
    source-address filtering; address claim with lower-NAME contention
    - Feeds the same gcu_inputs_t as the analog path (source-selected
    upstream); DM1 red lamp = shutdown class, amber = warning, comms
    silence while run-enabled = warning (SENSOR_LOSS covers escalation)
    - Stale DM1 drops lamp flags: stale severity is no severity
    - sim/plant.c: fake battery-powered engine ECU broadcasting at real
    J1939 rates (EEC1 20ms, EFL/P1 500ms, ET1/DM1 1s), fault knobs for
    bus silence and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
2026-08-16 Fix J1939 review findings: address-claim conformance, start/reset behavior
    - Cannot-claim (SA 254) transmitted on lost contention and in answer to
    address-claim requests while conflicted (J1939-81); NAME AAC bit
    cleared to match fixed-address behavior; equal-NAME rival treated as
    conflict so cloned units cannot storm the bus with claim defences
    - Destination-specific requests honored only when addressed to us
    - Fresh DM1 red stop lamp blocks starting (gated to STOPPED so an ECU
    bulb-check during preheat/crank cannot abort a start)
    - standstill_seen: rpm<10 observed during stop is remembered as
    stopped-evidence, so operator reset works after the engine ECU
    sleeps instead of waitin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
    [engine_fsm.c, engine_fsm.h, gcu_app.c, gcu_types.h, j1939.c, j1939.h]
2026-08-16 Sync docs with reviewed KiCad schematic and J1939 firmware
    - D80 SMBJ33A -> SMBJ33CA everywhere (calc sheet, guide, diagram 14)
    - VREF_MID dual feedback now concrete: R93 10k DC + C93 100n AC
    - Sender current-source implementation documented (4.5V ref from
    10k/90.9k off +5V, LM358 at +24V)
    - SWD: 10-pin Cortex header references -> TC2030 tag-connect (J11)
    - Relay contact wiring documented: GEN/MAINS volt-free pairs on J8;
    K1 run-enable from PREHEAT (J1939 ECU boot time)
    - Review-status section logs the KiCad SME review (9 findings) and
    the J1939 firmware review
    - Diagrams regenerated; both PDFs re-exported
2026-08-16 Assign footprints to all 299 components in schematic generator
    - By-ref exceptions + per-symbol defaults + value rules (wattage/voltage classes)
    - Field connectors: MKDS-3 for battery/AC/CT/relay terminals, MKDS-1,5 for signal
    - Q1 reverse-protection FET: Q_PMOS_GSD -> Q_PMOS_GDS + TO-252-2 (DPAK pad
    numbering 1=G 2=D 3=S; GSD variant would swap D/S in the netlist), part
    SQD50P06-15L
    - Verified: all footprint files exist in KiCad 7 libs, all symbol pin numbers
    present in footprint pads, netlist sweep still clean
    [ac_sense.kicad_sch, analog.kicad_sch, comms.kicad_sch, digital.kicad_sch, display.kicad_sch, ecu25-main.kicad_sch, mcu.kicad_sch, power.kicad_sch]
2026-08-16 Generate starting-point PCB: 200x150 2-layer, zoned placement, HV clearance rules
    - gen_pcb.py (pcbnew API): parses netlist, loads assigned footprints, places
    field connectors on board edges, relays 2x3 by J8, MCU central, remaining
    parts shelf-packed per subsystem zone; all pads netted; GND pour both layers
    - ecu25-main.kicad_dru: 2.5mm clearance on J5/J6 415V nets, 1.0mm on 330k
    chain interior nodes (derived from netlist at generation time)
    - Verified: no courtyard-bbox overlaps, nothing outside outline, every netlist
    node found a pad, 473 ratsnest edges pending routing
    - README: PCB section with regen + routing guidance
    [ecu25-main.kicad_pcb]
2026-08-16 Fix PCB SME review findings: relay pin map, 415V clearances, terminal creepage
    CRITICAL: G5LE-1 pin map — lib symbol/footprint has coil on pins 2/5, COM 1,
    NO 3, NC 4; generator assumed 1/2 coil + 3/4/5 contacts, netting all six
    relays dead (coil open, outputs on NC, volt-free GEN/MAINS contacts tied to
    logic GND through the driver FETs). Relay sheet rewired, verified by netlist.
    MAJOR fixes, all generator-side:
    - Volt-free contactor pairs split off J8 onto new J15; J5/J6/J15 are 8-pole
    5.08mm blocks with only odd poles wired (10.16mm live pitch) + pad remap —
    fully-populated 400V-class blocks don't meet PD2 creepage for 415V L-L /
    unsynchronized-source spacing
    - DRU rebuilt: GND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
    [ac_sense.kicad_sch, analog.kicad_sch, comms.kicad_sch, digital.kicad_sch, display.kicad_sch, ecu25-main.kicad_pcb, ecu25-main.kicad_sch, mcu.kicad_sch]
2026-08-16 Fix verification-pass findings: rule-area pads flag, corridor width, chain pitch
    - Rule areas: SetDoNotAllowPads/Footprints(False) — KiCad default True made
    every pad inside a keepout a DRC error (107 hits)
    - J15 corridor keepout widened 208 -> 209mm: GND pour edge was 2.70mm from
    J15 pad 1 vs the 3.0mm rule
    - AC-HV strip packing margin 1.2 -> 1.3mm: chain columns packed 2.94-2.96mm
    pad-to-pad, 40-60um under the line-class rule (12 DRC hits)
    - Loud warning on PAD_REMAP: 'Update PCB from Schematic' would silently move
    J5/J6/J15 nets back to pads 1-4 — board is regenerate-only
    - DRC re-run: 0 clearance violations, 0 keepout violations; remaining items
    are the documented pre-exist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
    [ecu25-main.kicad_pcb]
2026-08-25 Add BOM generator + breadboard prototyping guide; fix parts found by review
    New:
    - gen_bom.py: builds docs/bom/ecu25-main-bom.{md,csv} from the netlist —
    300 components in 91 order lines, grouped by orderable value + package,
    with part numbers for the actives and a shared-across-sheets section
    - docs/bom/breadboard-prototype.md: through-hole translation in eight blocks
    (digital input, relay driver, sender current source, VREF buffer, MPU
    comparator, CT, AC sense, comms), each with an explicit node list, a
    reference-schematic link, and a test that proves that block. Safety rules
    for the 415V sensing (not on a breadboard), CT open-circuit, grounding,
    and supply current limiting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
    [ac_sense.kicad_sch, analog.kicad_sch, comms.kicad_sch, digital.kicad_sch, display.kicad_sch, ecu25-main-bom.csv, ecu25-main.kicad_pcb, ecu25-main.kicad_sch]
2026-08-25 Add breadboard BOM workbook (xlsx) generated from the prototype guide
    gen_breadboard_xlsx.py parses docs/bom/breadboard-prototype.md — the reviewed
    source of truth — and emits docs/bom/ecu25-breadboard-bom.xlsx:
    - Cover: what it is, plus the git revision it was generated from
    - Safety: the warnings first, with the imperatives highlighted
    - Shopping List: 41 distinct parts summed across blocks, categorised, with a
    Buy column that adds spares (passives to a usable minimum, one spare per IC
    and for the hand-soldered relay), per-block quantities, and a Got column
    - Shared Kit, one tab per block A-H (wiring nodes, parts, warnings, test),
    Build Order
    Review findings fixed:
    - Three orde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
    [ecu25-breadboard-bom.xlsx]
2026-09-06 Convert hardware to 12 V system; pilot-duty output stage
    The target set is a Kirloskar KG4-25WS1 (engine 3R550ETA 4G1, CPCB IV+):
    12 V electrical system, 75 Ah battery, 3-cylinder CRDi with EGR + DOC.
    The board was designed 24 V throughout, which was wrong.
    Power:
    - Rails renamed +24V/+24V_SW -> +12V/+12V_SW
    - Buck UVLO 8.0 V -> 6.5 V (R3 30.1k), RON 100k -> 49.9k to hold ~300 kHz
    from a 12 V input
    - New D3 blocking Schottky + C9 2200uF hold-up on the buck input. UVLO now
    senses the hold-up node, not the battery: sensing the battery would trip EN
    the moment the harness sagged during crank and switch the buck off while C9
    still held charge. Sized for >50 ms down to 6.5 V with the bac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
    [ac_sense.kicad_sch, analog.kicad_sch, comms.kicad_sch, digital.kicad_sch, display.kicad_sch, ecu25-breadboard-bom.xlsx, ecu25-main-bom.csv, ecu25-main.kicad_pcb]
2026-09-06 12 V docs, diagrams, Modbus RTU slave, configurable AUX outputs
    Docs and diagrams brought in line with the 12 V hardware, plus the two
    firmware pieces the conversion implied.
    Modbus RTU slave (core/modbus.c) — specified since the original design doc
    but never built, while the RS485 hardware has been on the board all along:
    - Pure logic like j1939.c: caller hands over a framed request, gets a
    response. No UART or HAL, so it runs in the PC simulator
    - FC 03/04/06/16, CRC-16, exception responses, broadcast executed but never
    answered, address filtering
    - Input registers carry the live measurement snapshot (volts, currents,
    frequency, rpm, oil, coolant, fuel, battery, states, alarm bitm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
    [ECU25.kicad_pcb, ECU25.kicad_sch, ecu25-breadboard-bom.xlsx]
2026-09-06 Fix SME review findings on the 12 V conversion
    Two criticals, both of which would have reached a real installation:
    - gcu_config.c still carried 24 V battery thresholds (22 V low / 30 V high).
    On a 12 V set batt_low was permanently true, so 60 s after every power-up
    the alarm latched and pinned the horn relay on for good — while batt_high
    at 30 V could never trip, leaving a runaway regulator undetected exactly
    where the new 16 V TVS starts conducting. Now 11.0 / 15.5 V, with a
    regression test that runs 90 s at 13.8 V and asserts silence
    - docs/ecu-25-explained.md still told the installer to wire the starter
    solenoid straight to K2 at '16 A'. A G5LE-1 is 8 A DC and a 12 V start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
    [ac_sense.kicad_sch, analog.kicad_sch, comms.kicad_sch, digital.kicad_sch, display.kicad_sch, ecu25-breadboard-bom.xlsx, ecu25-main-bom.csv, ecu25-main.kicad_pcb]
2026-09-06 Fix SME verification findings; add COT ripple injection and the I/O map
    An independent verification pass re-derived the 12 V conversion fixes against
    the TI, Omron, Nexperia and ST datasheets instead of trusting the commit
    message. The hold-up energy math, the RON/UVLO arithmetic, the modbus_rx
    bounds, the AUX refactor and the dry-contact output stage all held. Eleven
    majors did not.
    Hardware:
    - The buck had no ripple-injection network. The LM5164 is constant-on-time:
    it restarts the on-time when FB falls to the 1.2 V reference, so it needs
    >=20 mV of FB ripple IN PHASE with the inductor current. Two 22 uF ceramics
    give 2.7 mV, and that component is capacitive, i.e. out of phase — t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
    [ac_sense.kicad_sch, analog.kicad_sch, comms.kicad_sch, digital.kicad_sch, display.kicad_sch, ecu25-breadboard-bom.xlsx, ecu25-main-bom.csv, ecu25-main.kicad_pcb]
2026-09-06 Fill the firmware gaps: AC measurement, sensor layer, runtime, STM32 port
    The three gaps that stood between a tested control core and a controller that
    could actually run on the board.
    AC measurement layer (core/ac_sense.c). The AC front end has been on the
    schematic since day one with nothing behind it: no RMS, no frequency, no
    power, and Modbus registers 19/20 publishing a hard zero.
    - RMS via mean(x^2) - mean(x)^2, so nothing has to be buffered
    - Frequency from interpolated rising zero crossings. Without the
    interpolation the reading quantises to sample_hz/N and a 47.5 Hz set reads
    either 49.2 or 50.8 with nothing in between
    - Real power as mean(v*i) - mean(v)*mean(i) per phase, sign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
2026-09-07 Fix firmware SME findings: two criticals in the AC/Modbus interaction
    Both criticals needed two modules read together to see.
    C1 — a routine Modbus poll could start the engine.
    plat_rs485_tx() busy-waited on TXE/TC for the whole response: 26.6 ms for the
    51-byte reply to a full input-register read at 19200 baud. The main loop is
    the only thing draining the ADC ring, and the ring held 8 sets = 2.5 ms, so
    it lapped ten times over with no overrun flag. ac_sense indexes zero
    crossings by SAMPLE NUMBER, so a hole in the stream reads as time that did
    not pass and comes straight out as a frequency error: a master reading all 23
    registers at 10 Hz pinned mains_hz at 53.3 Hz, outside amf_mains_hea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
    [ac_sense.kicad_sch, analog.kicad_sch, comms.kicad_sch, digital.kicad_sch, display.kicad_sch, ecu25-main.kicad_sch, mcu.kicad_sch, power.kicad_sch]
2026-09-07 Add a headless Specctra session importer; make routing observable
    Two things blocked the routing pipeline, both of them silent.
    route_pcb.py captured freerouting's output instead of streaming it, so an
    hour of CPU produced no visible progress and then hit the script's own
    3600 s cap — freerouting only writes the session after all passes finish, so
    that run was killed with nothing to show for it. Output now streams to
    ecu25-main/route.log, the pass count defaults to 3 rather than 100, and the
    timeout is an argument.
    KiCad 7's pcbnew.ImportSpecctraSES() only works inside the GUI. Called from a
    script it returns False and does nothing at all, which means a routing run
    could report success a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
2026-09-07 Fix PCB routing: pour keepouts blocked the router; add HV clearance gate
    The board would not autoroute past ~20% and the cause was not density.
    KiCad's Specctra exporter writes every rule area as a bare (keepout ...),
    losing the distinction between "no copper pour here" and "no traces here".
    This board's rule areas are pour-only — they exist to hold the ground pour
    out of the HV zone — so the router was locked out of 74 cm2 of a 300 cm2
    board containing 98 pads: the whole R300-R353 divider chain, the K2/K3/K4/K6
    relays and the J5/J6/J8/J15 mains terminals. Dropping the pour-only rule
    areas at export time takes the 2-layer board from 376 unrouted to 154.
    Creepage is unaffected: HV spacin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
    [ecu25-main.kicad_pcb]
2026-09-07 Add the ECU-25 project bible: full system explanation with circuit diagrams
    One document covering the whole project end to end: what the machine is,
    why the board is split and organized the way it is, then every circuit
    block with its own diagram and plain-language explanation of what it does,
    why it exists, and how it fails. Closes with the firmware architecture,
    the physical build, the staged safety/test plan, and an honest statement
    of what is actually built and verified today versus what is still open.
    Built from the existing ecu-25-explained.md and circuit-guide.md content,
    restructured into one narrative with all 21 circuit diagrams embedded
    inline rather than referenced by filename,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
